snepytago/Four-Wheel-Mecanum-Robot/bao_cao_ekf.pdf

## Ước lượng tư thế robot mecanum bằng bộ lọc Kalman mở rộng (EKF)

kết hợp camera ArUco, encoder bánh xe và con quay hồi chuyển

Đồ án FWMR — STM32F401RE

Tháng 10/2026

Tóm tắt nội dung

Báo cáo trình bày cơ sở toán học và cách hiện thực bộ lọc Kalman mở rộng (EKF) dùng để ước lượng tư thế (X, Y, θ) của robot 4 bánh mecanum trên hệ tọa độ của camera trần. Bộ lọc trộn ba nguồn: (i) độ dời thân xe tính từ 4 encoder qua động học thuận, (ii) vận tốc góc từ con quay MPU6050, (iii) tư thế tuyệt đối của mã ArUco do camera đo, vốn có trễ và nhiễu. Vector trạng thái được mở rộng thêm bias còn dư của con quay để bộ lọc tự hiệu chỉnh trong lúc chạy. Mọi công thức trong mã nguồn (ekf.c) đều được chứng minh từng bước: mô hình chuyển động và sai số rời rạc hóa, ma trận Jacobian, lan truyền hiệp phương sai, độ lợi Kalman tối ưu, tính quan sát được của bias, cổng loại ngoại lai χ
2 và cơ chế bù
trễ camera. Cuối báo cáo là một ví dụ số tính tay đầy đủ cho một chu kỳ lọc và kết quả mô phỏng.

## Mục lục

1 Đặt vấn đề | 3
2 Mô hình hệ thống | 3
3 Thuật toán EKF và các chứng minh | 6

### 4 Cổng loại ngoại lai χ

2 | 10
5 Bù độ trễ camera | 11
6 Khởi tạo | 12
7 Ví dụ số: một chu kỳ dự đoán và hiệu chỉnh | 13
8 Hiện thực trên STM32F401RE | 15
9 Kết quả mô phỏng | 15
10 Hạn chế và hướng phát triển | 16
A Đối chiếu ký hiệu với mã nguồn | 17

## 1 Đặt vấn đề

Robot cần biết chính xác vị trí và hướng của mình để bám đường thẳng hoặc đi tới một điểm. Hệ thống có ba nguồn thông tin với đặc tính bổ sung cho nhau (Bảng 1).

Bảng 1: Đặc tính ba nguồn đo trên robot

Encoder (4 bánh) | Gyro Z (MPU6050) Camera ArUco
Đại lượng | Độ dời thân xe
| ∆xb, ∆yb | Vận tốc góc ω | Tư thế tuyệt đối
| | | (X, Y, θ)
Tần số | 50 Hz | 50 Hz | ≈ 30 Hz, không đều
Độ trễ | ≈ 0 | ≈ 0 | τ ≈ 200 ms (ước
| | | lượng)
Nhiễu | Trượt bánh 0–3% | σ ≈ 0,05◦ khi đứng yên σθ = 0,53◦
| | | (đã đo)
Sai số dài hạn | Tích lũy theo quãng
| đường | Bias làm góc trôi
| | tuyến tính | Không trôi
Mất tín hiệu | Không | Không | Có (che marker)

Encoder và gyro cho thông tin liên tục, không trễ nhưng là tương đối: chỉ biết xe đã đi thêm bao nhiêu, và sai số cộng dồn theo thời gian. Camera cho thông tin tuyệt đối nhưng chậm, trễ và có lúc mất. Bộ lọc Kalman mở rộng là công cụ chuẩn để kết hợp hai loại nguồn này theo nghĩa tối ưu bình phương trung bình: dùng encoder + gyro để dự đoán, dùng camera để hiệu chỉnh, và trọng số giữa hai bên được tính tự động từ độ bất định của từng bên.

## 2 Mô hình hệ thống

### 2.1 Hệ tọa độ và quy ước

- Hệ thế giới {G}: hệ của camera trần, trục XG, YG nằm trên mặt sàn. Camera gửi x, y theo cm và θ theo rad; firmware đổi sang m và rad.
- Hệ thân xe {B}: gốc tại tâm robot, trục xb hướng về mũi xe, trục yb sang trái.
- Góc θ: góc từ XG tới xb, dương ngược chiều kim đồng hồ khi nhìn từ trên xuống. Quy ước này đã được kiểm chứng trên phần cứng (24/09/2026): xoay robot 90◦ ngược chiều kim đồng hồ, camera đọc 96,8
| ◦ và gyro đọc 96,7

◦
| | , cùng dấu.

Ma trận quay từ {B} sang {G}:
R(θ) = "
| | cos θ − sin θ
sin θ | cos θ
. | (1)

### 2.2 Động học mecanum: từ động học nghịch tới động học thuận

Theo quy ước Taheri và cộng sự (2015) đang dùng trong firmware, vận tốc góc 4 bánh ω =

[ωF L, ωF R, ωRL, ωRR]

T liên hệ với vận tốc thân xe v = [vx, vy, ωz]

T qua động học nghịch:

ω =

1
r

Jv, J =

1 −1 −K
1 | 1 | K
1 | 1 | −K
1 −1 | K
, | (2)

với r = 0,034 m là bán kính bánh và K = g + h = 0,17125 m.
Ở chiều ngược lại, ta có 4 phương trình nhưng chỉ 3 ẩn, nên hệ là quá xác định. Động học thuận được định nghĩa là nghiệm bình phương tối thiểu.

Mệnh đề 2.1 (Động học thuận). Nghiệm của bài toán minv∥Jv − rω∥
2
là

vx =

r
4

(ωF L + ωF R + ωRL + ωRR),

vy =

r
4

(−ωF L + ωF R + ωRL − ωRR),

ωz =

r
4K

(−ωF L + ωF R − ωRL + ωRR).

(3)

Chứng minh. Bước 1 (phương trình chuẩn). Đặt E(v) = (Jv − rω)

T(Jv − rω). Đạo hàm theo
v và cho bằng 0:
∇vE = 2J

T
(Jv − rω) = 0 =⇒ J

TJ v = r JTω.

Bước 2 (tính J

TJ). Gọi c1, c2, c3 là ba cột của J:

c1 = (1, 1, 1, 1)T

, | c2 = (−1, 1, 1, −1)T
, | c3 = (−K, K, −K, K)

T

Các tích vô hướng:

c

T
1 c1 = 1 + 1 + 1 + 1 = 4, | c

T
1 c2 = −1 + 1 + 1 − 1 = 0, c

T
2 c2 = 1 + 1 + 1 + 1 = 4, | c

T
1 c3 = −K + K − K + K = 0, c

T
3 c3 = 4K²
, | c T
2 c3 = (−1)(−K) + K + (−K) + (−1)K = 0.

Vậy J

TJ = diag(4, 4, 4K²
), ma trận đường chéo và khả nghịch vì K ̸= 0. Bước 3 (nghiệm). v = r (J

TJ)
−1J

Tω = r diag
| 1/4, 1/4,

1
4K²
| | J

Tω. Hàng thứ nhất của J

T là c

| | | T
| | | 1 =
(1, 1, 1, 1) nên vx =

r
4

P
i ωi

. Tương tự hàng thứ hai cho vy. Hàng thứ ba là c

| | T
3 = K(−1, 1, −1, 1),
nhân với r
4K² được ωz =

r
4K

(−ωF L + ωF R − ωRL + ωRR).
Bước 4 (cực tiểu). Ma trận Hessian 2J

TJ xác định dương nên điểm dừng là cực tiểu toàn cục.

Từ xung encoder tới độ dời. Trong một chu kỳ ∆t = 20 ms, encoder bánh i đếm được ni xung (đã nhân dấu ENC_SIGN). Với N = 1496 xung/vòng, góc quay của bánh là ∆φi = 2πni/N. Vì (3) tuyến tính, thay vận tốc góc bằng góc quay sẽ được thẳng độ dời thân xe ∆xb, ∆yb trong chu kỳ đó, không cần chia cho ∆t rồi nhân lại. Firmware nhân thêm hệ số trượt:

∆xb ← Kslip,x ∆xb, | ∆yb ← Kslip,y ∆yb, | Kslip,x = 0,97, Kslip,y = 0,75. | (4)

Thành phần quay ωz của (3) không được dùng trong EKF: góc quay lấy từ gyro, vì bánh mecanum trượt khi quay làm ωz tính từ encoder kém tin cậy.

### 2.3 Động học liên tục của tư thế

Vận tốc thân xe (vx, vy) được quay sang hệ {G} bằng (1):

X˙ = vx cos θ − vy sin θ, | Y˙ = vx sin θ + vy cos θ, | ˙θ = ω. | (5)

### 2.4 Rời rạc hóa theo góc trung điểm và sai số của nó

Firmware tích phân (5) bằng góc trung điểm θm = θk +

| 1 2∆θ:
"
Xk+1

Yk+1 #

=

"
| Xk
| Yk

| + R(θm)

"
| ∆xb
| ∆yb
| . | | (6)

Mệnh đề 2.2 (Sai số của phép tích phân trung điểm). Giả sử trong một chu kỳ ∆t vận tốc thân xe vb và vận tốc góc ω không đổi, đặt ∆θ = ω∆t và ∆pb = vb∆t. Khi đó độ dời chính xác trên {G} là

∆p

đúng

G = sinc ∆θ

2

R(θm) ∆pb, sinc(u) = sin u
u
. | (7)

Nghĩa là công thức trung điểm (6) đúng về hướng, chỉ sai về độ dài một tỉ lệ 1 − sinc(∆θ/2) = ∆θ

2/24 + O(∆θ

4
).

Chứng minh. Bước 1. Với θ(t) = θk + ωt, độ dời chính xác là ∆pG =

R ∆t
0 | R(θk + ωt) vb dt = hR ∆t
0 | R(θk + ωt) dti
vb.

Bước 2 (tích phân từng phần tử). Với ω ̸= 0:

Z ∆t

0

cos(θk + ωt) dt =

sin(θk + ∆θ) − sin θk
ω

=

2
ω

# cos

θk +

∆θ
2
sin ∆θ
2

,

Z ∆t

0

sin(θk + ωt) dt =

cos θk − cos(θk + ∆θ)
ω

=

2
ω

## sin

θk +

∆θ
2
sin ∆θ
2

,

dùng công thức biến hiệu thành tích

sin a − sin b = 2 cos a+b
2

sin a−b
2

, cos b − cos a = 2 sin a+b
2

sin a−b
2

Bước 3. Ghép lại thành ma trận: R ∆t
0 R dt =

2 sin(∆θ/2)
ω R(θm) = ∆t

sin(∆θ/2)
∆θ/2 R(θm). Nhân với vb
và dùng vb∆t = ∆pb ta được điều phải chứng minh. Khi ω → 0, sinc → 1 nên công thức vẫn đúng theo giới hạn.
Bước 4 (khai triển). sinc(u) = 1−u

2/6 +O(u

4
), thay u = ∆θ/2 được 1− ∆θ

2/24 +O(∆θ

4
).

Bảng 2: Sai số tương đối độ dài mỗi chu kỳ 20 ms: trung điểm so với Euler (dùng θk đầu chu kỳ)

Tình huống | ∆θ (rad) Trung điểm | Euler (lệch hướng)
∆θ
| | 2/24 | ≈ ∆θ/2
Chạy thẳng (ω ≈ 0,02 rad/s) | 4 · 10−4 | 7 · 10−9 | 2 · 10−4
Đổi hướng (ω = 0,6 rad/s) | 0,012 | 6 · 10−6 | 6 · 10−3
Xoay tại chỗ (ω = 1,5 rad/s) | 0,03 | 3,8 · 10−5 | 1,5 · 10−2

Bảng 2 cho thấy sai số rời rạc hóa của công thức trung điểm nhỏ hơn sai số encoder (cỡ 10−2 )
hàng nghìn lần, nên có thể bỏ qua.

### 2.5 Mô hình con quay và bias

Giá trị gyro đọc được (đã trừ bias hiệu chuẩn lúc khởi động) được mô hình hóa

ωm = ω + b + ng, ng ∼ N (0, σ²
g
), | (8)

trong đó b là bias còn dư: phần hiệu chuẩn lúc khởi động chưa trừ hết, hoặc do nhiệt độ thay đổi. Bias thay đổi chậm, mô hình hóa bằng quá trình Wiener (bước ngẫu nhiên) ˙b = nb.

Bổ đề 2.3. Rời rạc hóa ˙b = nb với mật độ phổ q
2
b

trên chu kỳ ∆t cho bk+1 = bk + wb với Var(wb) = q

2
b ∆t.

Chứng minh. wb =

R tk+∆t

tk

nb(s) ds. Vì nb là nhiễu trắng, E[nb(s)nb(s

′
)] = q

2
b

δ(s − s

′
), do đó
Var(wb) = RR E[nb(s)nb(s
′

)] ds ds′ =

R tk+∆t

tk

q

2
b

ds = q

2
b∆t.

### 2.6 Mô hình trạng thái rời rạc

Vector trạng thái (4 biến):

x =

h

X Y θ biT
(m, m, rad, rad/s).

Đầu vào mỗi chu kỳ: uk = [∆xb, ∆yb, ωm]

T và ∆t đo thực tế.
Mô hình chuyển động xk+1 = f(xk, uk) + wk:

ω¯ = ωm − bk, θm = θk +
1/2 ω¯∆t,

Xk+1 = Xk + ∆xb cos θm − ∆yb sin θm,

Yk+1 = Yk + ∆xb sin θm + ∆yb cos θm,

θk+1 = wrap(θk + ¯ω∆t),

bk+1 = bk.

(9)

Mô hình đo (khi có khung camera):

z =

Xc
Yc
θc
- = Hx + v, H =

1 0 0 0
0 1 0 0
0 0 1 0
- = [ I3 0 ], | v ∼ N (0, R). | (10)

Hàm wrap(·) đưa góc về (−π, π]. Mô hình đo là tuyến tính; phần phi tuyến chỉ nằm ở mô hình chuyển động (các hàm sin, cos của θ), vì vậy cần bộ lọc Kalman mở rộng.

## 3 Thuật toán EKF và các chứng minh

Bộ lọc giữ ước lượng xˆ và ma trận hiệp phương sai P = E[(x − xˆ)(x − xˆ)

T]. Mỗi chu kỳ gồm
bước dự đoán (luôn chạy, 50 Hz) và bước hiệu chỉnh (chỉ khi có khung camera).

### 3.1 Tuyến tính hóa: ma trận Jacobian F

Mệnh đề 3.1 (Jacobian của mô hình chuyển động). Đặt a = −∆xb sin θm − ∆yb cos θm và β = ∆xb cos θm − ∆yb sin θm. Khi đó

F =

∂f
∂x
xˆk

=

1 0 a −

∆t
2

a
0 1 β −

∆t
2

β
0 0 1 | −∆t
0 0 0 | 1
. | (11)

Chứng minh. Lấy đạo hàm riêng từng hàng của (9) theo từng biến trạng thái.

Bước 1 (biến trung gian). θm = θ +

1/2(ωm − b)∆t nên ∂θm
∂θ = 1,

∂θm
∂b = −

∆t
2

, và θm không phụ
thuộc X, Y .
Bước 2 (hàng X). ∂Xk+1
∂X = 1,

∂Xk+1
∂Y = 0. Theo quy tắc dây chuyền:

∂Xk+1
∂θ =

∂Xk+1
∂θm

·

∂θm
∂θ = (−∆xb sin θm − ∆yb cos θm) · 1 = a,

∂Xk+1
∂b = a ·
−

∆t
2

Bước 3 (hàng Y ). Tương tự, ∂Yk+1 ∂θm

= ∆xb cos θm − ∆yb sin θm = β, nên ∂Yk+1

∂θ | = β và ∂Yk+1
∂b | =

−

∆t
2

β.

Bước 4 (hàng θ). θk+1 = θ + (ωm − b)∆t cho ∂θk+1 ∂θ = 1,

∂θk+1
∂b = −∆t. (Hàm wrap chỉ cộng bội số 2π, đạo hàm bằng 1.)

Bước 5 (hàng b). bk+1 = b cho hàng (0, 0, 0, 1).

Nhận xét. Gọi (∆X, ∆Y ) = R(θm)(∆xb, ∆yb) là độ dời trên {G} trong chu kỳ. So với (9) thấy ngay a = −∆Y và β = ∆X. Ý nghĩa: sai lệch góc δθ làm điểm cuối lệch đi δθ ·(−∆Y, ∆X), tức vector độ dời bị quay 90◦ và nhân δθ. Đó chính là “cánh tay đòn” biến sai số góc thành sai số vị trí.

### 3.2 Lan truyền hiệp phương sai

Mệnh đề 3.2. Với sai số ước lượng ek = xk − xˆk có trung bình 0, hiệp phương sai Pk, và nhiễu quá trình wk trung bình 0, hiệp phương sai Qk, độc lập với ek, thì đến bậc nhất:

P

−
k+1 = F PkF
T + Qk. | (12)

Chứng minh. Bước 1 (khai triển Taylor). f(xk, u) = f(xˆk, u) + F(xk − xˆk) + O(∥ek∥

2
).
Bước 2 (sai số sau dự đoán). Dự đoán xˆ

−
k+1 = f(xˆk, u), nên e

−
k+1 = xk+1 − xˆ

−
k+1 ≈ Fek + wk.
Bước 3 (trung bình). E[e

−
k+1] = FE[ek] + E[wk] = 0.

Bước 4 (hiệp phương sai).

E[e

−
k+1e

−T
k+1] = FE[eke

T
k

]F

T + FE[ekwT
k

] + E[wke

T
k

]F

T + E[wkwT
k

].

Hai số hạng giữa bằng 0 vì ek và wk độc lập, trung bình 0. Còn lại F PkF

T + Qk.

### 3.3 Xây dựng ma trận nhiễu quá trình Q

Q có cấu trúc khối Q = diag(Qxy, qθ, qb), mỗi khối mô tả một nguồn sai số vật lý.

a) Khối vị trí. Sai số độ dời encoder tỉ lệ với quãng đường (trượt bánh) cộng một mức sàn:
σx = kx d + σ0, | σy = ky d + σ0, | d =

q
∆x

2
b + ∆y

2
b
, | (13)

với kx = 0,03 (trượt 0–3% đã đo), ky = 0,10 (hướng ngang kém tin cậy hơn), σ0 = 0,5 mm. Các sai số này nằm trong hệ {B} và cần quay sang {G}.

Mệnh đề 3.3. Nếu δpb ∼ N (0, Σb) với Σb = diag(qx, qy), qx = σ
2
x

, qy = σ

2
y

, thì δpG = R(θm)δpb
có hiệp phương sai

Qxy =

"
c

2
qx + s

2
qy cs(qx − qy)
cs(qx − qy) s

2
qx + c

2
qy
, | c = cos θm, s = sin θm. | (14)

Chứng minh. Cov(R δpb) = R ΣbRT. Tính từng bước:

RΣb =

"
c −s
s | c # "qx | 0
| 0 | qy

=

"
cqx | −sqy
sqx | cqy

,

RΣbR

T =

"
cqx | −sqy
sqx | cqy
# " c | s

−s c#

=

"
c

2
qx + s

2
qy | cs qx − cs qy
cs qx − cs qy | s

2
qx + c

2
qy

Khi qx = qy khối này trở thành qxI, không phụ thuộc hướng; khi qy > qx (hướng ngang kém tin), số hạng chéo khác 0 và elip bất định nằm dọc theo trục ngang của thân xe, đúng như mong đợi.

b) Khối góc. σθ = σg∆t + ks|ω¯∆t|, gồm nhiễu gyro σg = 0,5

◦/s và sai số tỉ lệ khi xoay
ks = 2%. Vậy qθ = σ

2
θ

c) Khối bias. Theo Bổ đề 2.3: qb = (0,02◦/s)
2
- ∆t (đơn vị ◦/s/√
s đổi sang rad).

### 3.4 Bước hiệu chỉnh: độ lợi Kalman tối ưu

Khi có phép đo z, ước lượng được hiệu chỉnh tuyến tính theo sai lệch đo (innovation) r = z−Hxˆ

−:

xˆ

+ = xˆ

− + Kr. | (15)

Định lý 3.4 (Độ lợi Kalman). Đặt S = HP −HT + R. Ma trận K làm cực tiểu tổng phương sai sai số tr P

+ = E∥x − xˆ
+∥

2
là
K = P

### −HTS

−1
, | (16)

và với K này, P

+ = (I − KH)P

−.

Chứng minh. Bước 1 (sai số sau hiệu chỉnh). Với z = Hx + v:

e

+ = x − xˆ

− − K(Hx + v − Hxˆ

−) = (I − KH)e

− − Kv.

Bước 2 (hiệp phương sai, dạng Joseph). Vì e

− và v độc lập, trung bình 0:

P

+ = (I − KH)P

−(I − KH)

T + KRKT
. | (17)

Bước 3 (khai triển).

P

+ = P

− − KHP − − P

−HTKT + KHP −HTKT + KRKT

= P

− − KHP − − P

−HTKT + KSKT

Bước 4 (lấy vết và đạo hàm theo K). Dùng các đẳng thức đạo hàm ma trận ∂ tr(KA) ∂K = AT,
∂ tr(AKT)
∂K = A,

∂ tr(KBKT)
∂K = K(B + BT):

∂ tr P

+
∂K = −(HP −)

T − P

−HT + 2KS = −2P

−HT + 2KS,

vì P

− và S đối xứng. Cho bằng 0 được K = P

### −HTS

−1
Bước 5 (cực tiểu). tr P

+ là hàm bậc hai theo K với phần bậc hai tr(KSKT). S xác định dương (xem Bước 6) nên hàm lồi chặt, điểm dừng là cực tiểu toàn cục.

Bước 6 (S khả nghịch). P

− nửa xác định dương, R xác định dương, nên với mọi y ̸= 0: y

TSy = (HTy)

TP

−(HTy) + y

TRy > 0.

Bước 7 (rút gọn P

+). Từ K = P

### −HTS

−1
suy ra KS = P

−HT, nên KSKT = P

−HTKT.
Thay vào Bước 3, hai số hạng −P

−HTKT và +KSKT triệt tiêu: P
+ = P

− − KHP − =

(I − KH)P

−.

Nhận xét (Trực giác 1 chiều). Với một biến vô hướng, H = 1: K =

p
p + r

và p

+ =

p r
p + r

. Nếu dự

đoán chắc chắn hơn camera (p ≪ r) thì K → 0, bỏ qua camera. Nếu camera chắc hơn (r ≪ p) thì K → 1, tin camera. Khi p = r: K =
1/2 và p

+ =

r
2

, tức độ lệch chuẩn giảm √ 2 lần. Ví dụ số
ở Mục 7 cho đúng kết quả này.

### 3.5 Rút gọn với H = [ I3 0 ]

Với H ở (10), các tích ma trận trở nên rất đơn giản:

HP −HT = P
−
1:3, 1:3, | P −HT = P
−
1:4, 1:3, | (18)

tức chỉ cần cắt ma trận, không cần nhân. Do đó

S = P

−
1:3,1:3 + R, | K = P

−
1:4,1:3 S

−1
(4 × 3), P ⁺
ij = P

−
ij −

X

3

m=1

KimP

−
mj . | (19)

Đây đúng là ba vòng lặp trong ekf_update_cam.

Nghịch đảo 3 × 3. Firmware tính S

−1 = adj(S)/ det S bằng phần bù đại số. Với Cij = (−1)i+jMij (Mij là định thức con bỏ hàng i, cột j): det S =

P
j S1jC1j (khai triển theo hàng
1) và (S

−1
)ij = Cji/ det S. Chứng minh: (S adj S)ik =

P
j SijCkj ; khi i = k đây là khai triển det S theo hàng i; khi i ̸= k đây là định thức của ma trận có hai hàng bằng nhau, bằng 0. Vậy S adj S = (det S)I.

Sai lệch góc. Camera trả θc ∈ (−π, π] nên sai lệch góc phải chuẩn hóa: rθ = wrap(θc − ˆθ −).
Ví dụ θc = 179◦
,

ˆθ
− = −179◦

: hiệu thô là 358◦
, nhưng hai hướng chỉ cách nhau −2

◦
; không
chuẩn hóa thì bộ lọc sẽ quay ước lượng gần một vòng.

### 3.6 Bias gyro quan sát được: vì sao EKF học được b

Không cảm biến nào đo trực tiếp b (hàng 4 của H bằng 0), nhưng bộ lọc vẫn ước lượng được nó.

Mệnh đề 3.5 (Tính quan sát được). Cặp (F, H) của (11), (10) quan sát được với mọi ∆t > 0.

Chứng minh. Ma trận quan sát được là O =

H
HF
. Ba hàng của H là e

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
. Hàng thứ ba

của HF là hàng thứ ba của F: (0, 0, 1, −∆t). Trừ đi e

T
3 được (0, 0, 0, −∆t), độc lập tuyến tính với e1, e2, e3 khi ∆t ̸= 0. Vậy rank O = 4.

Cơ chế cụ thể thấy rõ trên mô hình rút gọn hai biến (θ, b) khi xe đứng yên.

Ví dụ 3.6 (Một chu kỳ trên mô hình (θ, b)). Giả sử P = diag(pθ, pb), F2 =

"
1 −∆t

0 1 #
, bỏ qua

Q.
Dự đoán:

F2P F T
2 =

"
pθ | −∆t pb
0 | pb
# " 1 | 0

−∆t 1

=

"
pθ + ∆t
2pb | −∆t pb
−∆t pb | pb

Phần tử chéo −∆t pb là tương quan âm giữa sai số góc và sai số bias: bias ước lượng thấp hơn thật thì góc dự đoán sẽ cao hơn thật.
Hiệu chỉnh với camera góc (H2 = [1 0], phương sai đo rc): S = pθ + ∆t

2pb + rc và

K =

1
S

"
pθ + ∆t

2pb
−∆t pb

, δb = K2 rθ = −

∆t pb
S

rθ.

Diễn giải: nếu camera thấy góc nhỏ hơn dự đoán (rθ < 0), tức gyro đã báo quay nhiều hơn thực tế, thì δb > 0: bias được tăng lên và từ chu kỳ sau ω¯ = ωm − b nhỏ đi. Sau nhiều chu kỳ, các hiệu chỉnh nhỏ này cộng dồn và ˆb hội tụ về bias thật (Hình 1).

Đây là lợi ích lớn nhất của EKF trong hệ này: khi còn thấy camera, toàn bộ quãng chạy trở thành một phiên hiệu chuẩn gyro liên tục, nên khi mất camera (che marker), góc vẫn bền hơn nhiều so với chỉ hiệu chuẩn một lần lúc khởi động.

## 4 Cổng loại ngoại lai χ

2

Camera có thể trả khung sai (nhận nhầm marker, nhiễu ảnh). Firmware loại khung có khoảng cách Mahalanobis lớn:
d

2 = r

TS
−1
r > γ = 16,3. | (20)

Mệnh đề 4.1. Nếu mô hình đúng thì r ∼ N (0, S) và d
2 ∼ χ
2/3(phân phối chi bình phương 3 bậc tự do).

Chứng minh. Bước 1. r = He

− + v là tổ hợp tuyến tính của các biến Gauss trung bình 0, nên Gauss với hiệp phương sai HP −HT + R = S.
Bước 2 (làm trắng). S xác định dương nên có phân tích Cholesky S = LLT. Đặt y = L
−1
r:
Cov(y) = L

−1SL−T = L

−1LLTL

−T = I3, nên y1, y2, y3 độc lập, cùng phân phối N (0, 1).

Bước 3. d

2 = r

T(LLT)
−1
r = (L

−1
r)

T(L
−1
r) = y

2
1 + y

2
2 + y

2/3, chính là định nghĩa của χ

2/3.

Bảng 3: Ngưỡng cổng và xác suất loại nhầm một khung đúng

Mức tin cậy | Ngưỡng γ = F

−1
χ

2
3
| | Xác suất loại nhầm
95% | 7,81 | 5%
99% | 11,34 | 1%
99,9% (đang dùng) | 16,27 | 0,1%

Nạp lại khi bị loại liên tiếp. Nếu 10 khung liên tiếp bị loại, có nhiều khả năng chính EKF đã sai (ví dụ đặt sai độ trễ, hoặc xe bị nhấc lên), nên firmware đặt lại X, Y, θ theo khung camera và giữ nguyên bias. Với khung đúng, xác suất 10 lần loại nhầm liên tiếp là (10−3
)

10 = 10−30
,
không đáng kể.

## 5 Bù độ trễ camera

Khung camera nhận ở thời điểm t mô tả vị trí robot ở thời điểm chụp t − τ . Firmware lưu lịch sử trạng thái của 64 chu kỳ gần nhất (1,28 s) và so khung camera với trạng thái lúc chụp.

### 5.1 Sai số khi không bù trễ

Mệnh đề 5.1. Xe chạy thẳng với vận tốc v dọc trục X. Nếu so khung camera với trạng thái hiện tại, ước lượng ở trạng thái ổn định bị kéo lùi một lượng xấp xỉ vτ (khi bộ lọc tin camera nhiều).

Chứng minh. Bỏ qua nhiễu: Xc(t) = X(t − τ ) = X(t) − vτ . Sai lệch đo r = Xc − Xˆ(t) = (X(t) − Xˆ(t)) − vτ . Ở trạng thái ổn định, bước hiệu chỉnh kéo r về quanh 0 (giữa hai lần cập nhật encoder chỉ cộng đúng độ dời thật), nên X(t) − Xˆ(t) → vτ , tức ước lượng nằm sau vị trí thật đúng vτ .

Với v = 0,5 m/s và τ = 0,2 s, sai số là 10 cm. Hình 2 (mô phỏng) cho kết quả ≈ 95 mm, đúng như dự đoán.

### 5.2 Phương pháp bù và sai số còn lại

Gọi xˆ(t − τ ) là trạng thái lưu trong lịch sử. Sai lệch đo dùng trong firmware là

r = z − Hxˆ(t − τ ), | (21)

còn hiệu chỉnh δ = Kr được cộng vào trạng thái hiện tại.

Mệnh đề 5.2. Viết xˆ(t) = xˆ(t − τ ) ⊕ ∆ˆ , trong đó ∆ˆ là độ dời odometry trong khoảng [t − τ, t]. Hiệu chỉnh (δX, δY, δθ) tính tại t−τ khi cộng thẳng vào trạng thái hiện tại có sai số vị trí không vượt quá |δθ| · ∥∆p∥ ≤ |δθ| vτ .

Chứng minh. Bước 1. Nếu tại t − τ tư thế được sửa thành (X + δX, Y + δY, θ + δθ) thì, chạy lại odometry từ đó, độ dời trong [t − τ, t] được quay thêm δθ: ∆p

′ = R(δθ)∆p.

Bước 2. Vị trí hiện tại đúng phải là p(t − τ ) + (δX, δY ) + R(δθ)∆p. Firmware dùng p(t − τ ) + (δX, δY ) + ∆p. Hiệu hai biểu thức là (R(δθ) − I)∆p.

Bước 3. ∥(R(δθ) − I)u∥ = 2|sin(δθ/2)| ∥u∥ ≤ |δθ| ∥u∥ (độ dài dây cung). Với ∥∆p∥ ≤ vτ ta có điều phải chứng minh. Góc được hiệu chỉnh chính xác vì phép cộng góc giao hoán.

Ví dụ: δθ = 1◦ = 0,0175 rad, v = 0,5 m/s, τ = 0,2 s cho sai số tối đa 1,75 mm, nhỏ hơn 50 lần so với không bù.

### 5.3 Phải dịch cả lịch sử

Mệnh đề 5.3. Sau khi cộng δ vào trạng thái hiện tại, nếu không cộng δ vào mọi phần tử lịch sử thì hiệu chỉnh này bị áp dụng lặp lại ở khung sau.

Chứng minh. Khung kế tiếp có thời điểm chụp t

′−τ , thường vẫn nằm trước thời điểm hiệu chỉnh t, nên được so với phần tử lịch sử xˆh chưa sửa. Khi đó r

′ = z

′ − Hxˆh =

z

′ − H(xˆh + δ)

+ Hδ.
Số hạng Hδ là phần sai lệch đã được sửa nhưng lại xuất hiện trong r

′
, nên bị cộng thêm lần
nữa, gây vọt lố. Cộng δ vào toàn bộ lịch sử làm số hạng này biến mất.

Xấp xỉ còn lại. Firmware dùng P hiện tại thay cho P(t − τ ) khi tính S và K. Trong 0,2 s, P chỉ tăng thêm ≈ 10 lần Q của một chu kỳ, nhỏ so với R, nên ảnh hưởng không đáng kể. Phương pháp chính xác hơn (nhân bản trạng thái, chạy lại toàn bộ lịch sử) tốn bộ nhớ và thời gian tính hơn nhiều mà không cần thiết ở đây.

## 6 Khởi tạo

Trung bình N khung. Khi xe đứng yên, firmware lấy trung bình N = 10 khung camera. Với các khung độc lập, phương sai của trung bình là σ

2/N, nên độ lệch chuẩn vị trí ban đầu giảm
√
10 ≈ 3,2 lần.

Trung bình góc theo đường tròn. Không được lấy trung bình cộng các góc: 179◦ và −179◦ cho trung bình cộng 0

◦

, trong khi hướng đúng là 180◦ . Firmware dùng
¯θ = atan2X

i

sin θi
,

X

i

cos θi

. | (22)

Mệnh đề 6.1. ¯θ cực tiểu hàm L(µ) = P

i

1 − cos(θi − µ)
, tức tổng bình phương khoảng cách dây cung giữa các điểm e

iθk và e
iµ trên đường tròn đơn vị (chia 2).

Chứng minh. Trước hết |e

iθk − e
iµ|

2 = 2 − 2 cos(θk − µ). Đạo hàm:

L

′
(µ) = −

X

i

sin(θi − µ) = − cos µ

X

i

sin θi + sin µ

X

i

cos θi

Cho bằng 0 được tan µ =

Psin θi/

Pcos θi
. Trong hai nghiệm cách nhau π, L

′′(µ) = Pcos(θi −

µ) = C cos µ + S sin µ (với C =

Pcos θi
, S =

Psin θi) dương khi (cos µ,sin µ) cùng hướng với

(C, S), đúng nghiệm mà atan2(S, C) trả về.

Hiệp phương sai ban đầu. P0 = diag
σ

2

xy, σ²

xy, σ²

θ,c, σ²
b,0
với σxy = 1 cm, σθ,c = 0,53◦ ,

σb,0 = 0,5

◦/s; ˆb0 = 0. Trong 3 s đếm ngược (xe đứng yên, camera vẫn chạy), bộ lọc học bias trước khi xe chuyển động (Hình 1).

## 7 Ví dụ số: một chu kỳ dự đoán và hiệu chỉnh

Các số dưới đây được tính bằng đúng thuật toán của ekf.c, làm tròn để trình bày. Đơn vị: m, rad, rad/s.

Dữ liệu. Trạng thái đầu xˆ = (1,000; 0,500; 0,17453; 0), tức θ = 10◦ , ngay sau khởi tạo nên
P = P0 = diag(10−4

, 10−4

, 8,557 · 10−5

, 7,615 · 10−5
). Đầu vào một chu kỳ: ∆xb = 0,0098 m
(0,49 m/s), ∆yb = 0,0002 m, ωm = 0,0100 rad/s, ∆t = 0,02 s.

Bước 1 — Dự đoán trạng thái

ω¯ = 0,0100 − 0 = 0,0100, θm = 0,17453 + 1
2

(0,0100)(0,02) = 0,17463,

c = cos θm = 0,98479, s = sin θm = 0,17375,
X− = 1,000 + 0,0098(0,98479) − 0,0002(0,17375) = 1,009616,

Y

− = 0,500 + 0,0098(0,17375) + 0,0002(0,98479) = 0,501900,

θ

− = 0,17453 + 0,0100(0,02) = 0,174733, b− = 0.

Bước 2 — Jacobian

a = −0,0098(0,17375) − 0,0002(0,98479) = −1,8997 · 10−3 ,
β = 0,0098(0,98479) − 0,0002(0,17375) = 9,6162 · 10−3
,

F =

1 0 −1,8997 · 10−3 | 1,8997 · 10−5
0 1 | 9,6162 · 10−3 | −9,6162 · 10−5
0 0 | 1 | −0,02
0 0 | 0 | 1

Bước 3 — Nhiễu quá trình

d =

p
0,0098² + 0,0002² = 9,802 · 10−3 m; σx = 0,03d + 0,0005 = 7,941 · 10−4 , σy = 0,10d +
0,0005 = 1,480 · 10−3

; qx = 6,305 · 10−7

, qy = 2,191 · 10−6
. Theo Mệnh đề 3.3:

Q11 = c

2
qx + s

2

qy = 6,776 · 10−7
, Q22 = s

2
qx + c

2

qy = 2,144 · 10−6
,
Q12 = cs(qx − qy) = −2,670 · 10−7 ,

σθ = (0,5

◦

/s)(0,02) + 0,02 · |0,0100 · 0,02| = 1,785 · 10−4

rad ⇒ Q33 = 3,187 · 10−8
,
Q44 = (0,02◦
/s đổi ra rad/s)

2

- 0,02 = 2,437 · 10−9

Bước 4 — Hiệp phương sai dự đoán P

− = F P F T + Q

P

− =

1,0068 · 10−4 | −2,686 · 10−7 | −1,626 · 10−7 | 1,45 · 10−9
−2,686 · 10−7 | 1,0215 · 10−4 | 8,230 · 10−7 | −7,32 · 10−9
−1,626 · 10−7 | 8,230 · 10−7 | 8,5629 · 10−5 | −1,523 · 10−6
1,45 · 10−9 | −7,32 · 10−9 | −1,523 · 10−6 | 7,6157 · 10−5

Kiểm tra một phần tử: P

−
34 = F33P33F43 + F34P44F44 = 0 + (−0,02)(7,615 · 10−5 )(1) = −1,523 ·
10−6
. Đây chính là tương quan âm giữa θ và b đã phân tích ở Ví dụ trên.

Bước 5 — Khung camera và sai lệch đo

Camera báo z = (1,0090; 0,5035; 0,1700):

r = z − Hxˆ

− = (−6,16 · 10−4

; 1,600 · 10−3

; −4,733 · 10−3
),

tức −0,6 mm, +1,6 mm và −0,27◦ .

Bước 6 — S, cổng χ
2
, độ lợi K

R = diag(10−4

, 10−4

, 8,557 · 10−5
),

S = P

−
1:3,1:3 + R =
2,0068 · 10−4 | −2,69 · 10−7 | −1,63 · 10−7
−2,69 · 10−7 | 2,0215 · 10−4 | 8,23 · 10−7
−1,63 · 10−7 | 8,23 · 10−7 | 1,7120 · 10−4
- ,

d

2 = r

TS
−1
r = 0,146 < 16,3 ⇒ nhận khung.

K = P

−
1:4,1:3S

−1 =

0,5017 | −6,6 · 10−4 | −4,7 · 10−4
−6,6 · 10−4 | 0,5053 | 2,38 · 10−3
−4,0 · 10−4 | 2,03 · 10−3 | 0,5002
1,3 · 10−9 | −6,7 · 10−9 | −8,897 · 10−3

Các phần tử đường chéo ≈ 0,5 vì ngay sau khởi tạo P

− ≈ R: theo nhận xét 1 chiều, K = p/(p + r) = 1/2. Hàng 4 (bias) chỉ khác 0 đáng kể ở cột góc, nhờ P

−
34 ̸= 0.

Bước 7 — Cập nhật

δ = Kr = (−3,08 · 10−4

; 7,98 · 10−4

; −2,364 · 10−3

; 4,21 · 10−5
),

xˆ

+ = (1,009308; 0,502698; 0,172369; 4,21 · 10−5

) ⇐⇒ θ = 9,876◦

, b = 0,0024◦
/s.

Độ lệch chuẩn sau cập nhật: σX = 7,08 mm, σY = 7,11 mm, σθ = 0,375◦

, σb = 0,49996◦/s. So
với trước (10 mm, 10 mm, 0,53◦

) đều giảm khoảng √
2 lần, đúng như Nhận xét 1 chiều. Bias thay đổi rất ít ở khung đầu tiên vì tương quan P

−
34 mới tích lũy được một chu kỳ; nó lớn dần qua các chu kỳ sau.

Bước 8 — Dịch lịch sử

Cộng (δX, δY, δθ) = (−0,31; 0,80 mm; −0,135◦ ) vào cả 64 phần tử lịch sử.

## 8 Hiện thực trên STM32F401RE

Khối lượng tính toán. Mỗi chu kỳ dự đoán: F P F T gồm 2×64 = 128 phép nhân–cộng, cộng Q và đối xứng hóa. Mỗi lần hiệu chỉnh: nghịch đảo 3 × 3 (≈ 30 phép tính), K (36), cập nhật P (48), dịch lịch sử (192 phép cộng). Tổng dưới 1000 phép tính dấu phẩy động mỗi chu kỳ, tức khoảng vài chục micro giây trên nhân Cortex-M4F có FPU, rất nhỏ so với chu kỳ 20 ms.

Ổn định số. Sau mỗi bước, P được đối xứng hóa P ← 1
2

(P + P

T) để chặn sai số làm tròn làm P mất đối xứng. Dạng P

+ = (I − KH)P

− được dùng thay dạng Joseph (17) để tiết kiệm phép tính; với float 32 bit và các phần tử P cỡ 10−9–10−4

(rất xa giới hạn 10−38), mô phỏng chưa cho thấy dấu hiệu mất xác định dương.

Khung camera “đóng băng”. Khi mất marker, phía PC gửi lại đúng pose cũ. Lúc xe đang chạy, hai khung giống hệt nhau là không thể xảy ra, nên firmware bỏ qua chúng.

Bảng 4: Tham số EKF trong config.h

Ký hiệu | Tên trong code | Giá trị | Nguồn
σxy (trong R) EKF_R_XY_M | 0,01 m | Ước lượng, chưa đo
σθ,c (trong R) EKF_R_TH_DEG | 0,53◦ | Đo 24/09/2026
kx | EKF_Q_ENC_X | 0,03 | Trượt 0–3% đã đo
ky | EKF_Q_ENC_Y | 0,10 | Ước lượng
σ0 | EKF_Q_ENC_MIN_M | 0,5 mm | Ước lượng
σg | EKF_Q_GYRO_DPS | 0,5
◦/s | Ước lượng (đo: 0,05° góc khi đứng yên)
ks | EKF_Q_GYRO_SCALE 0,02 | Ước lượng
qb | EKF_Q_BIAS_DPS | 0,02◦/s/√
s Ước lượng
σb,0 | EKF_B0_DPS | 0,5
◦/s | Ước lượng
γ | EKF_GATE | 16,3 | χ

2/3, 99,9%
τ | EKF_CAM_DELAY_MS 200 ms | Ước lượng, cần đo lại

## 9 Kết quả mô phỏng

Lưu ý: các kết quả trong mục này là mô phỏng trên máy tính (mô hình robot có nhiễu camera, bánh RR yếu 8%, bias gyro 0,4

◦/s, encoder đọc dư 3%), dùng để kiểm chứng tính đúng của thuật toán. Kết quả trên xe thật sẽ được bổ sung từ log.

Bảng 5: Bài go-to-point mô phỏng, 7 vị trí xuất phát ngẫu nhiên. τthật là độ trễ camera trong mô phỏng; firmware đặt τ = 200 ms.

τthật (ms) | Số lần | Sai số vị trí cuối | Sai số hướng
200 (đúng) | 4 | 2–5 mm | < 0,6

◦
100 hoặc 350 | 2 | 14–20 mm | < 0,3

◦
500 | 1 | 4 mm (sau khi tự chỉnh theo camera lúc
đứng yên)

0,1

◦

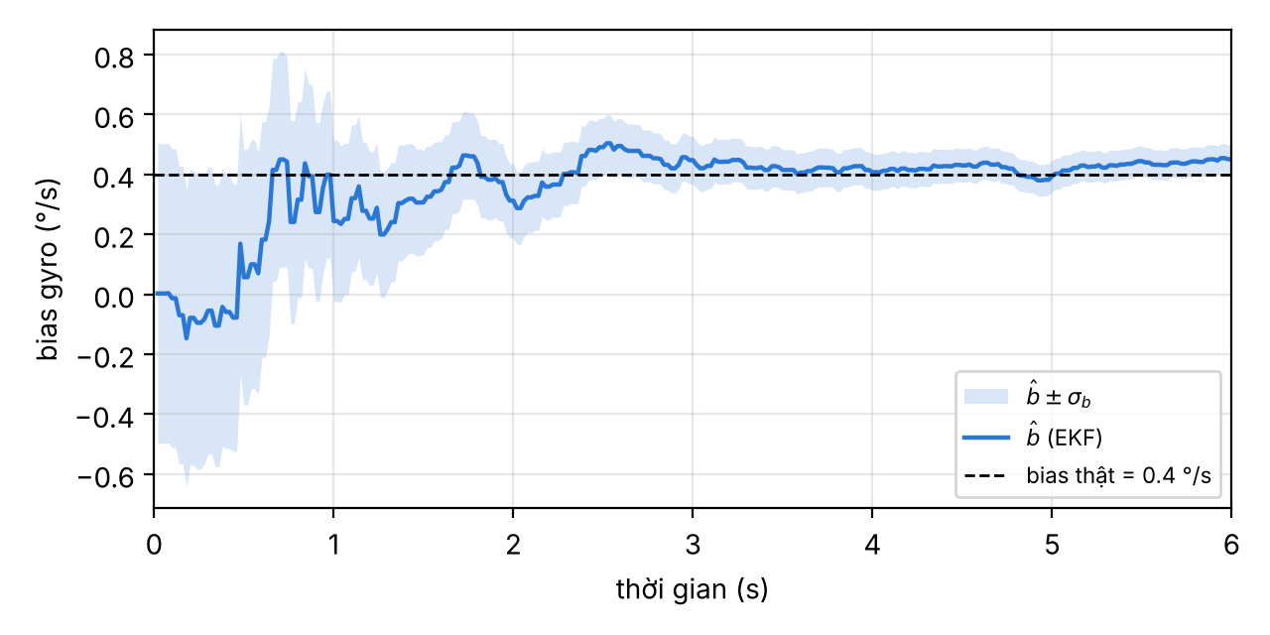
[picture p4: figure]

Hình 1: Hội tụ của bias gyro khi xe đứng yên, camera 30 Hz. Bias thật 0,4

◦/s; sau 3 s đếm ngược
ˆb = 0,45 ± 0,08◦/s, sau 6 s độ bất định còn ±0,05◦/s.

Với bài chạy thẳng 3 m có vòng giữ hướng và vòng kéo ngang dựa trên EKF, mô phỏng cho độ lệch ngang lớn nhất 6 mm và góc lệch lớn nhất 0,7

◦

## 10 Hạn chế và hướng phát triển

1. Độ trễ τ chưa đo. Theo Mệnh đề 5.1, sai ∆τ gây sai số cỡ v ∆τ khi đang chạy. Có thể đo bằng cách cho xe dừng đột ngột và so thời điểm encoder hết xung với thời điểm camera thấy xe dừng, hoặc thêm số thứ tự khung/timestamp vào gói tin camera.
2. Rxy chưa đo. Cần ghi pose camera khi xe đứng yên trong vài chục giây để tính độ lệch chuẩn thật của x, y.
3. Độ trễ giả định không đổi. Nếu độ trễ dao động mạnh, nên ước lượng nó theo từng khung.
4. Hệ số trượt Kslip,x, Kslip,y có thể đưa vào vector trạng thái để EKF tự ước lượng, giống cách đã làm với bias.
5. Đoạn mất camera (“hầm”). Bộ lọc đã tự chạy bằng dự đoán khi không có khung; cần thí nghiệm che marker để đo sai số lúc ra khỏi hầm.

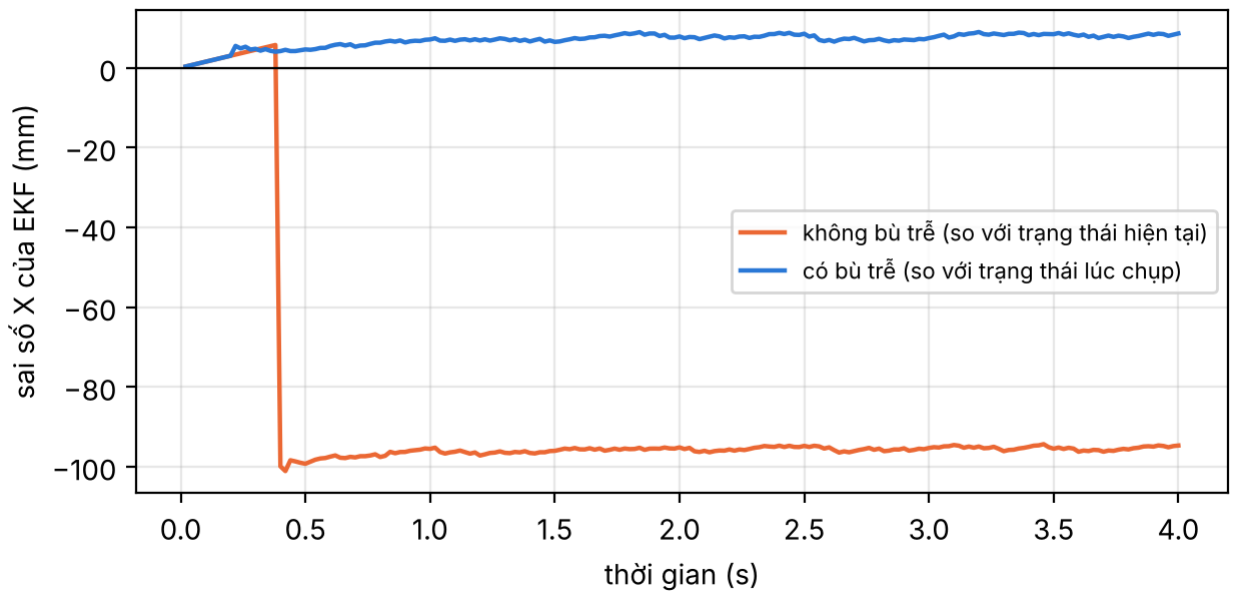
[picture p5: figure]

Hình 2: Sai số X của EKF khi xe chạy thẳng 0,5 m/s, camera trễ 200 ms. Không bù trễ: sau khi bị loại 10 khung liên tiếp, bộ lọc nạp lại theo camera và ổn định ở ≈ −95 mm, khớp với −vτ = −100 mm của Mệnh đề 5.1. Có bù trễ: sai số ≈ 8 mm, phần lớn do encoder đọc dư 3% mà bộ lọc phải liên tục kéo về.

## A Đối chiếu ký hiệu với mã nguồn

Ký hiệu | Biến/hàm trong ekf.c Ghi chú
xˆ = (X, Y, θ, b) s[0..3] | ekf_x/y/th/bias()
P | P[4][4]
∆xb, ∆yb | dx, dy | FK × K_SLIP
ωm | gz | rad/s
θm | tm
a, β | a, b | (11)
qx, qy | qx, qy | Mệnh đề 3.3
r | r[3] | so với lịch sử
S, S−1 | S, Si | phần bù đại số

d

2 | d2 | cổng χ
| | 2
K | K[4][3] | (16)
δ | d[4] | cộng vào trạng thái và lịch sử
Lịch sử | hx, hy, hth, ht | 64 phần tử
