snepytago/Four-Wheel-Mecanum-Robot/Claude outputs/fig1.png

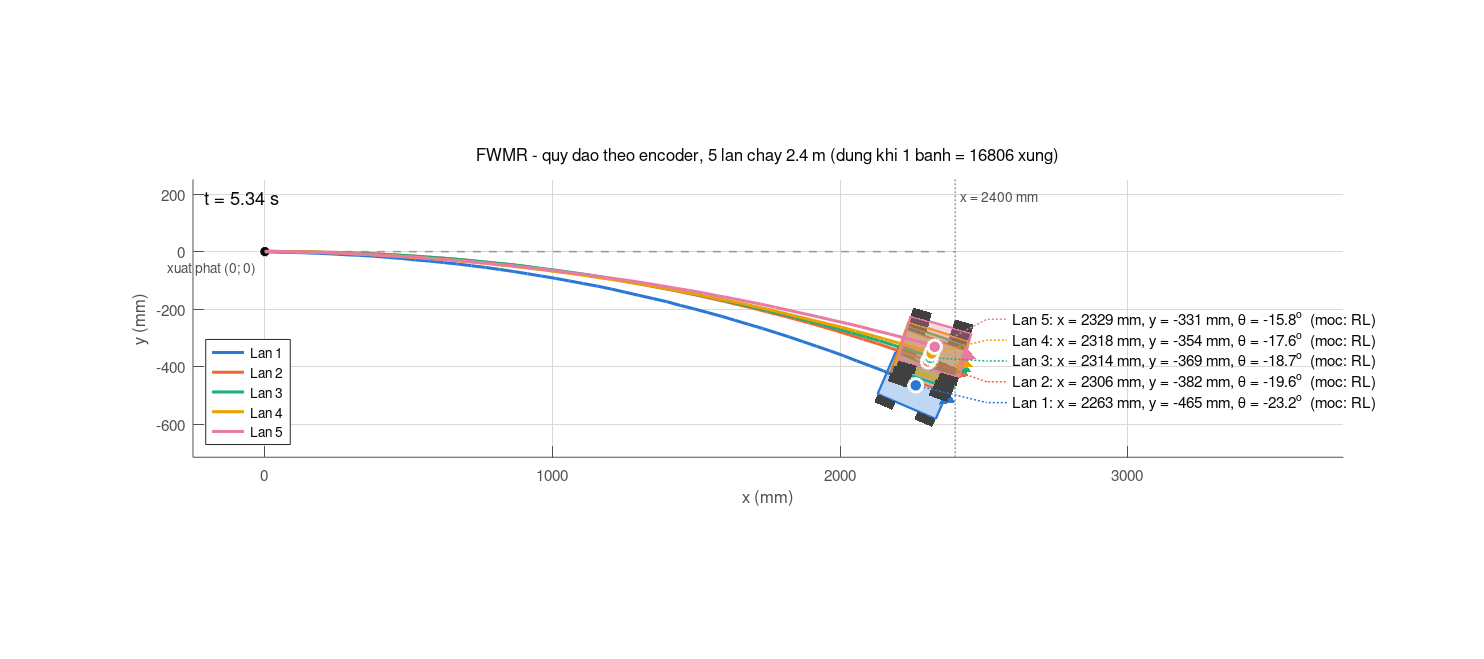
Claude outputs/fig1.png
