snepytago/Four-Wheel-Mecanum-Robot/Claude outputs/xem_truoc_quy_dao.png

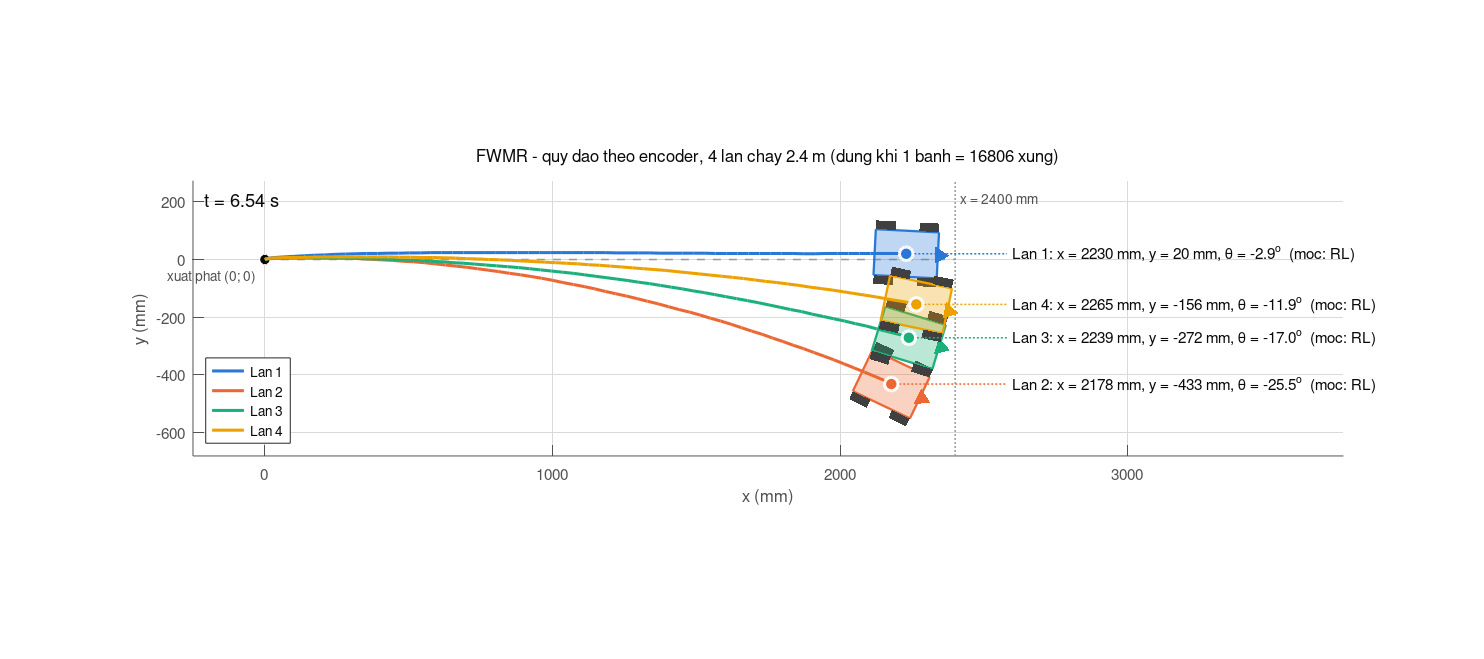
Claude outputs/xem_truoc_quy_dao.png
