snepytago/Four-Wheel-Mecanum-Robot/matlab_plot/ekf_lan_loi_camera.png

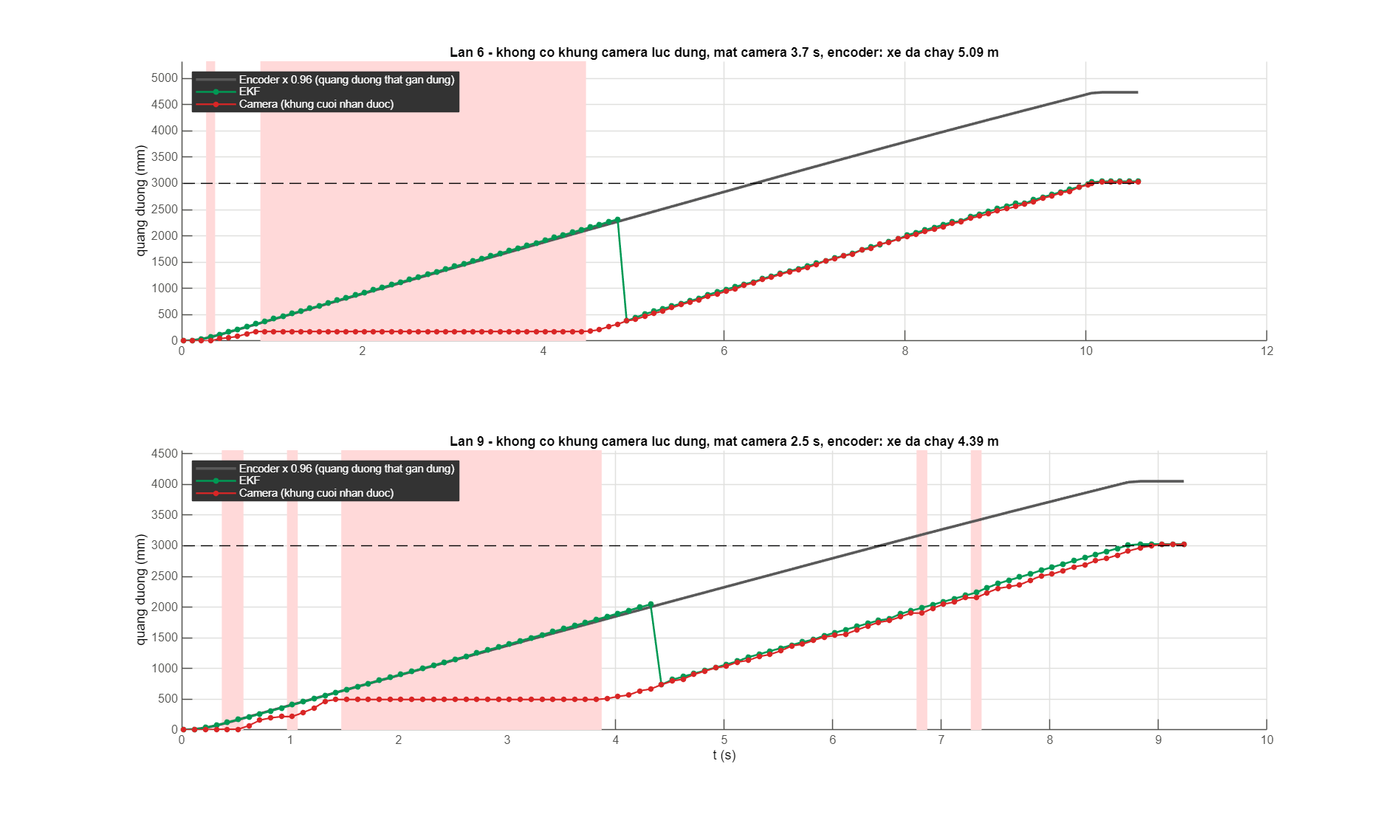
matlab_plot/ekf_lan_loi_camera.png
