snepytago/Four-Wheel-Mecanum-Robot/matlab_plot/ekf_so_sanh_chi_so.png

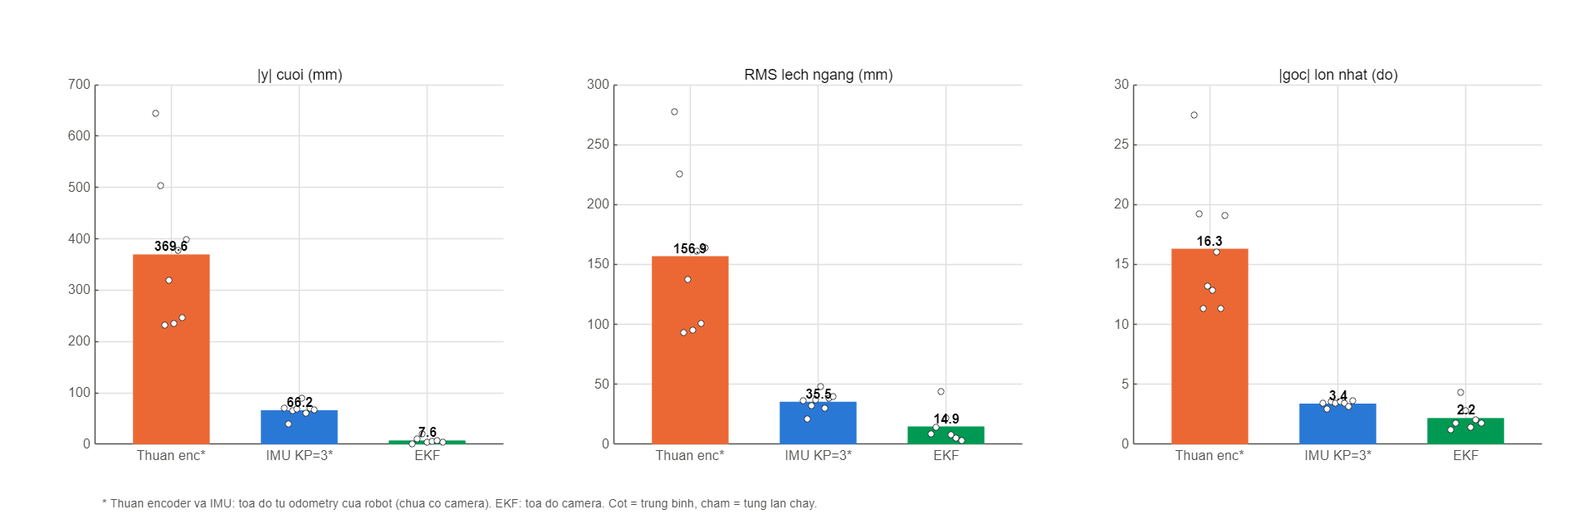
matlab_plot/ekf_so_sanh_chi_so.png
