snepytago/Four-Wheel-Mecanum-Robot/matlab_plot/ekf_so_sanh_quy_dao.png

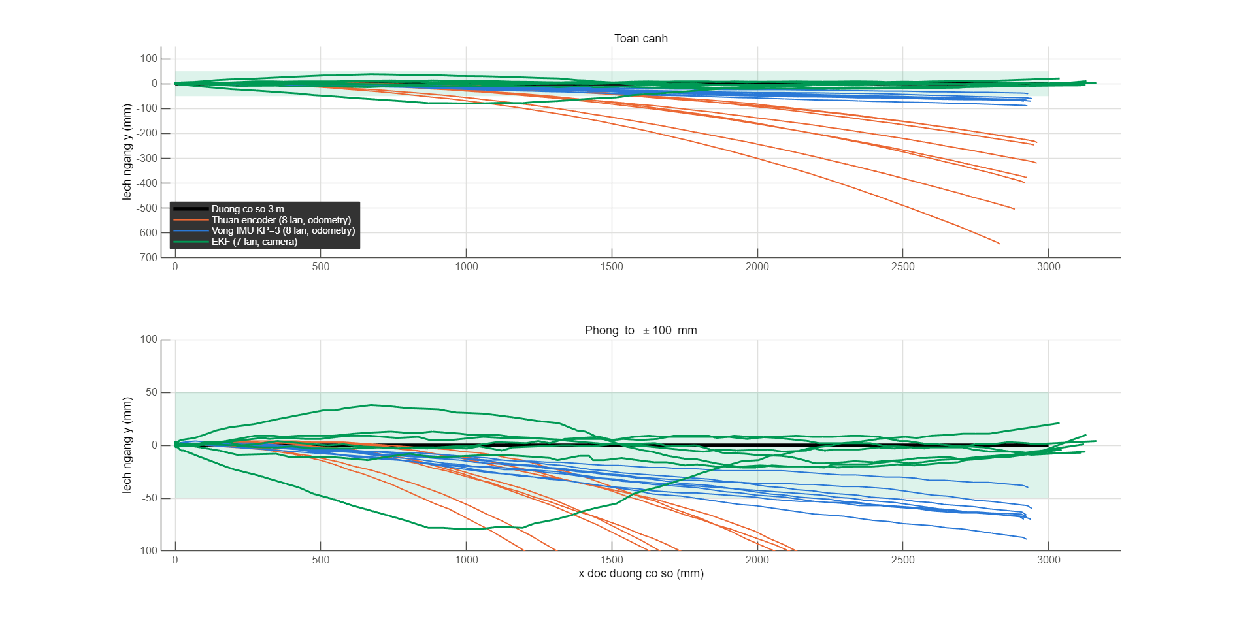
matlab_plot/ekf_so_sanh_quy_dao.png
