snepytago/Four-Wheel-Mecanum-Robot/matlab_plot/ekf_truoc_sau_sua.png

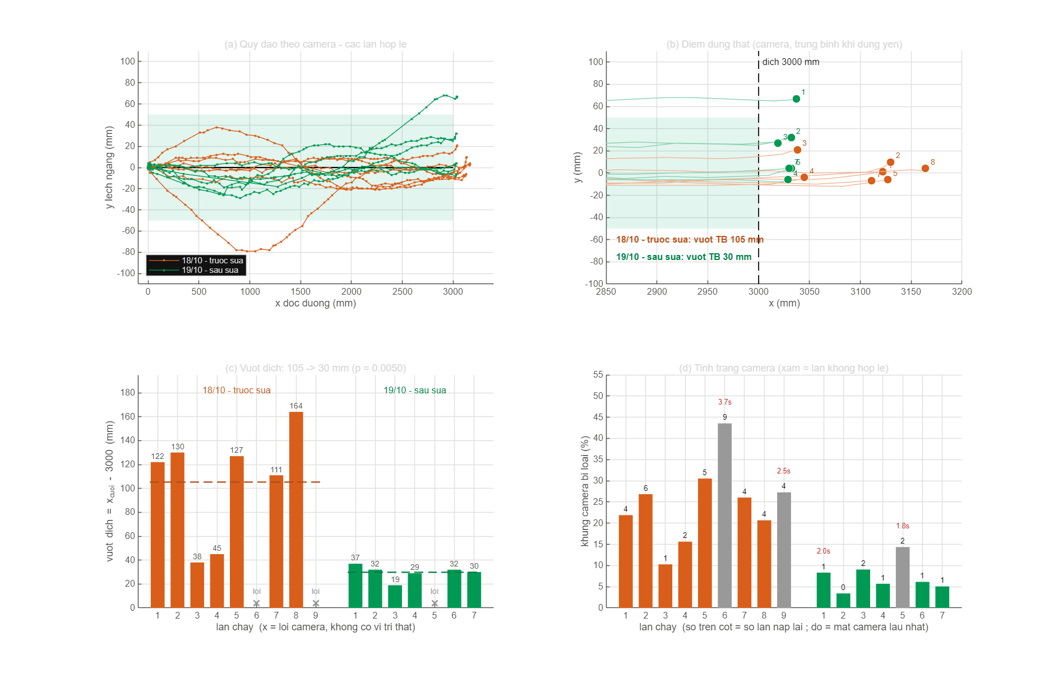
matlab_plot/ekf_truoc_sau_sua.png
