snepytago/Four-Wheel-Mecanum-Robot/matlab_plot/log_imu_kp3_07102026_yaw.png

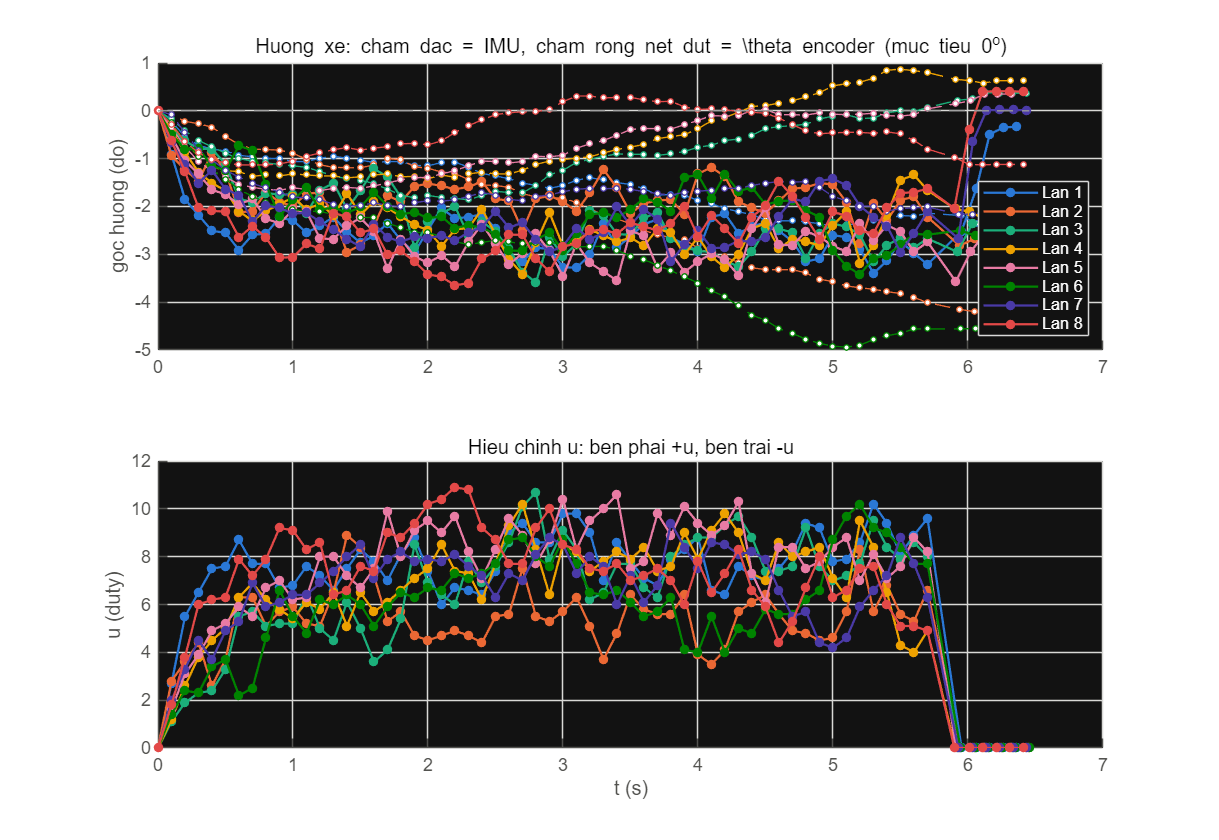
matlab_plot/log_imu_kp3_07102026_yaw.png
