snepytago/Four-Wheel-Mecanum-Robot/matlab_plot/log_zigzag_mode2_20102026_zigzag.png

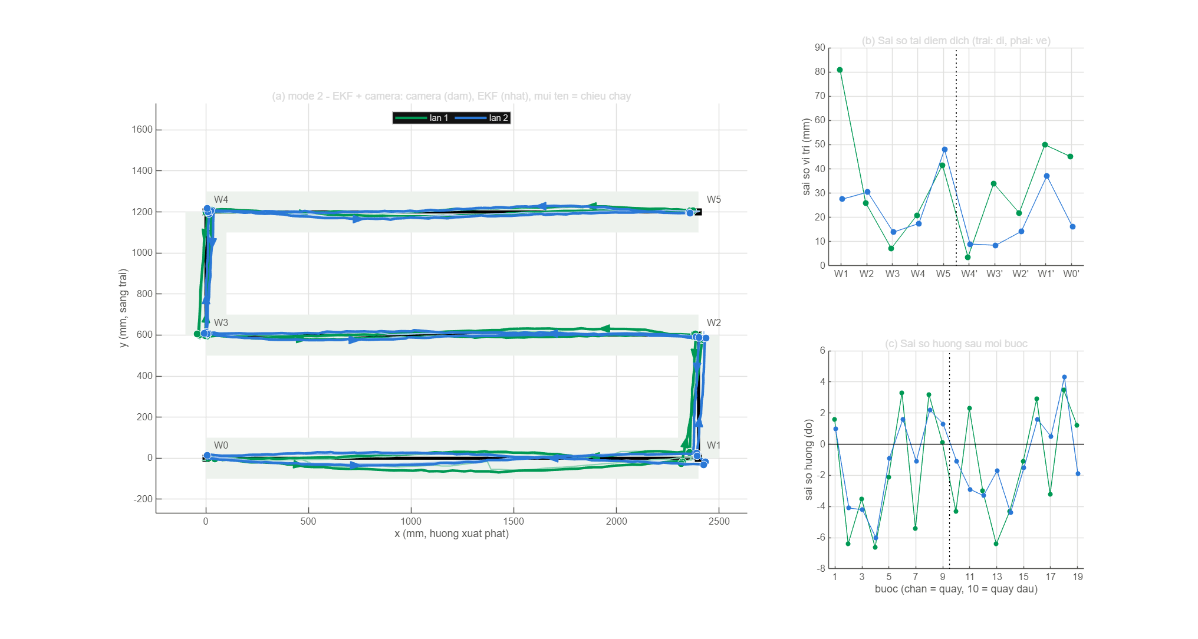
matlab_plot/log_zigzag_mode2_20102026_zigzag.png
