snepytago/Four-Wheel-Mecanum-Robot/matlab_plot/slide_ekf_9lan.png

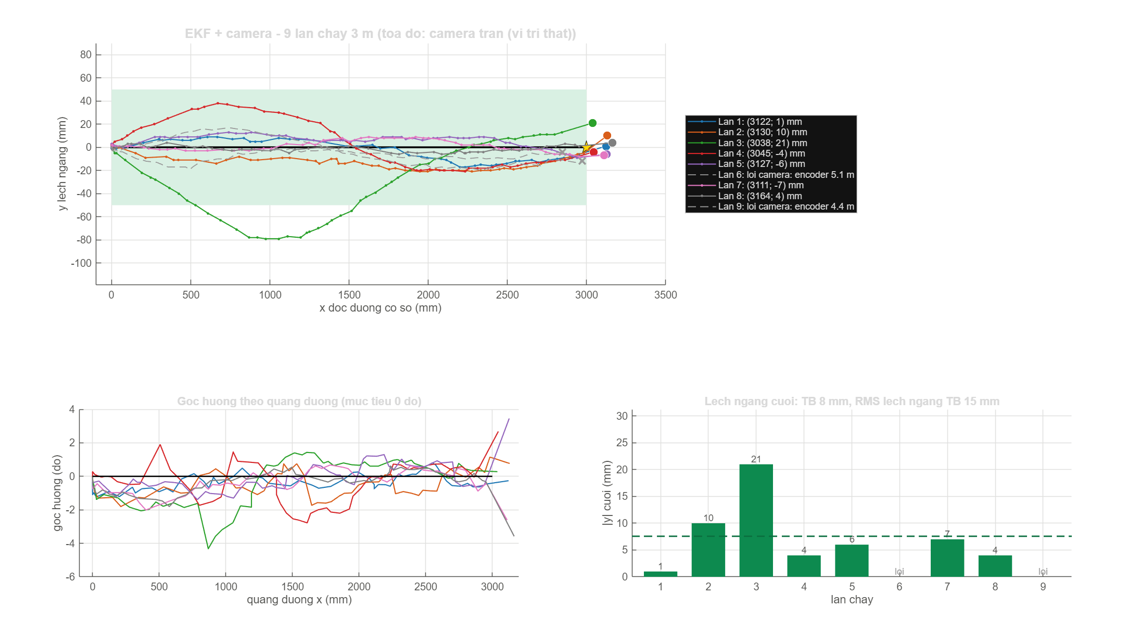
matlab_plot/slide_ekf_9lan.png
