snepytago/Four-Wheel-Mecanum-Robot/matlab_plot/slide_enc_8lan.png

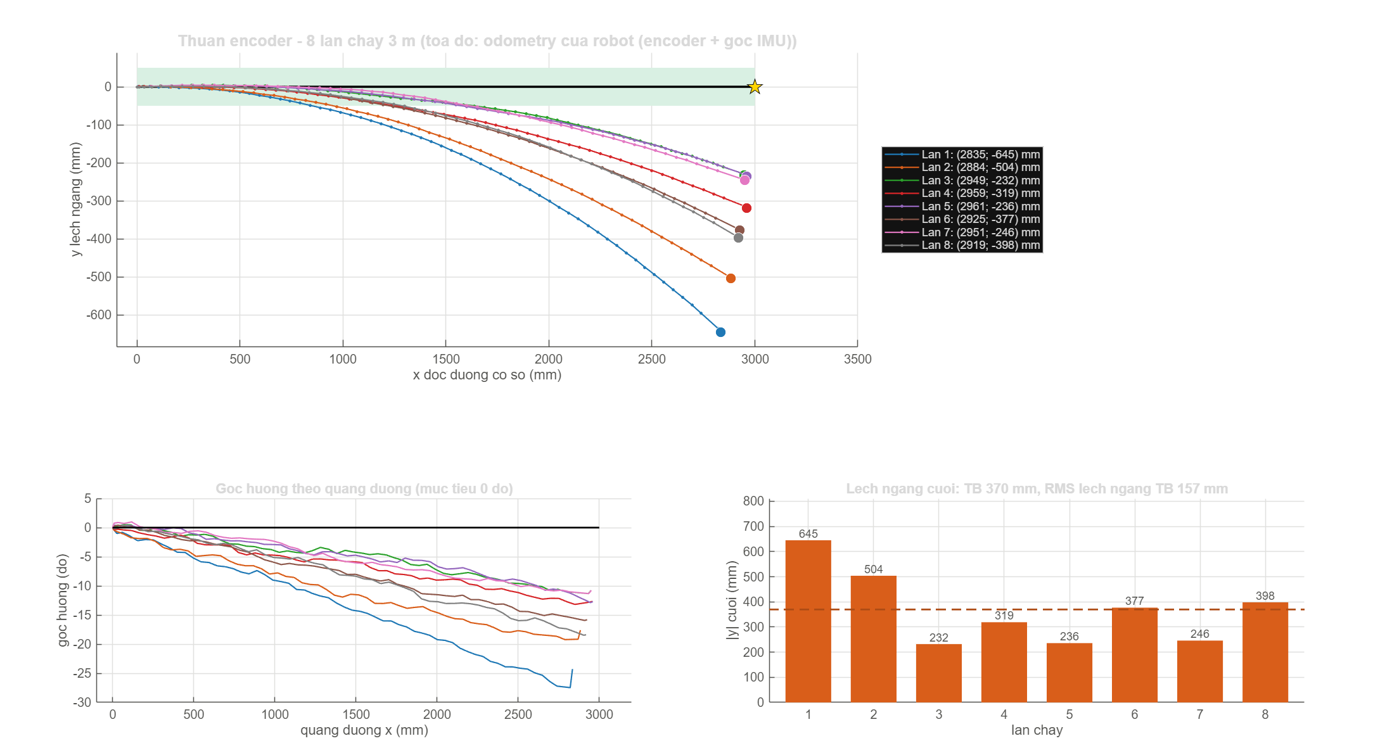
matlab_plot/slide_enc_8lan.png
