snepytago/Four-Wheel-Mecanum-Robot/matlab_plot/slide_imu_8lan.png

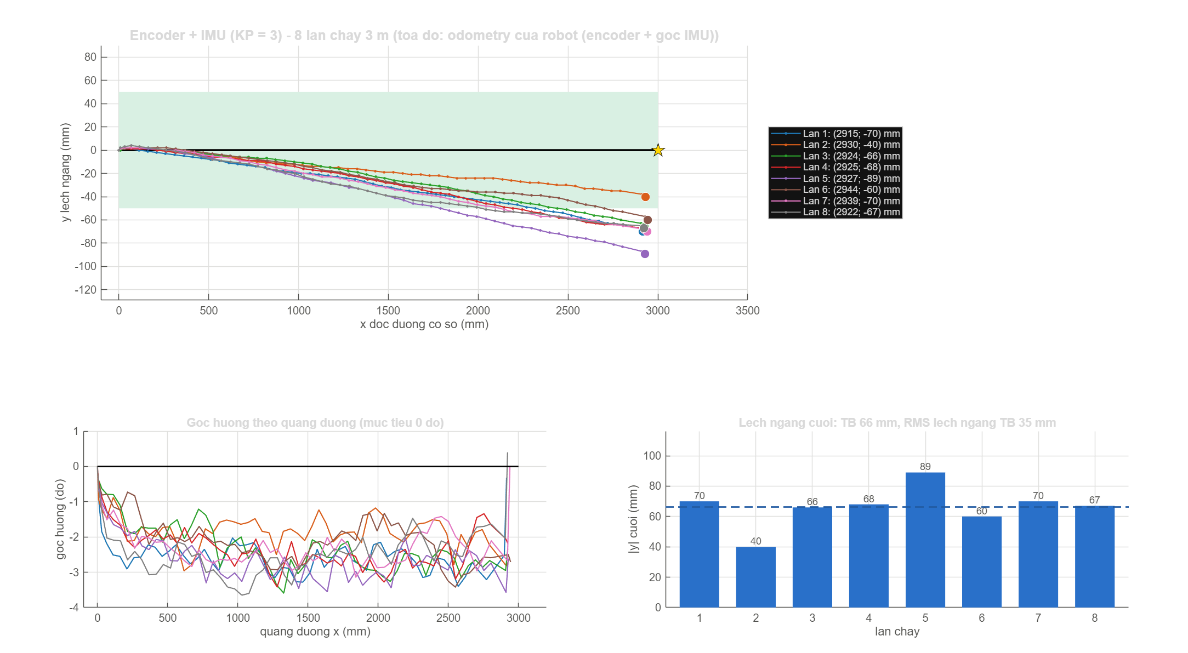
matlab_plot/slide_imu_8lan.png
