snepytago/Four-Wheel-Mecanum-Robot/matlab_plot/slide_so_sanh_tot_nhat.png

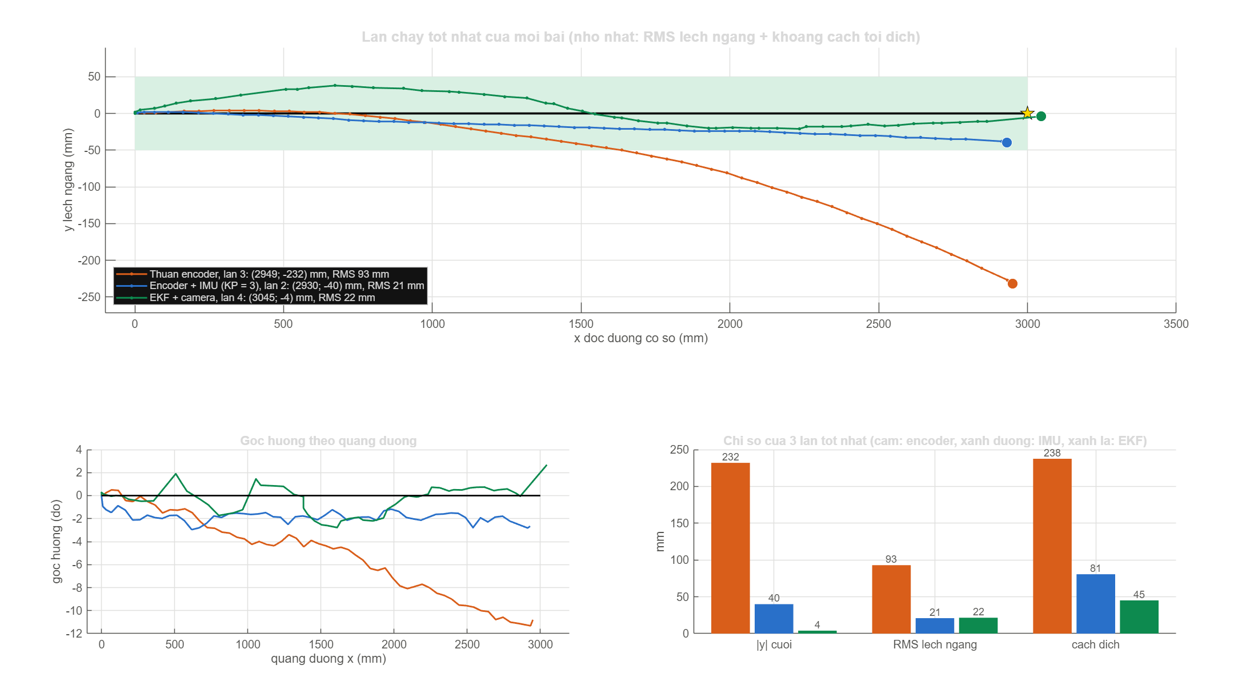
matlab_plot/slide_so_sanh_tot_nhat.png
