snepytago/Four-Wheel-Mecanum-Robot/matlab_plot/so_sanh_lan_1.png

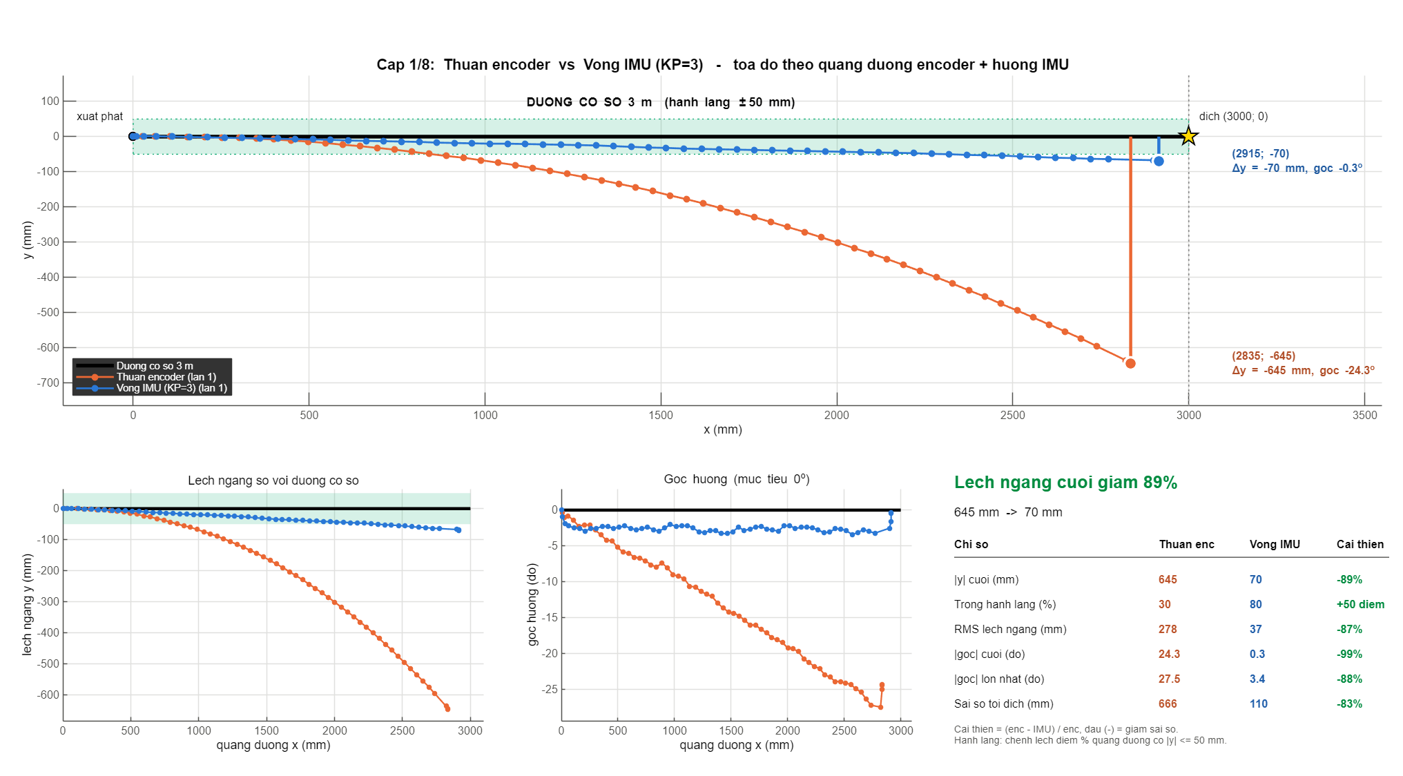
matlab_plot/so_sanh_lan_1.png
