snepytago/Four-Wheel-Mecanum-Robot/matlab_plot/so_sanh_tong_hop.png

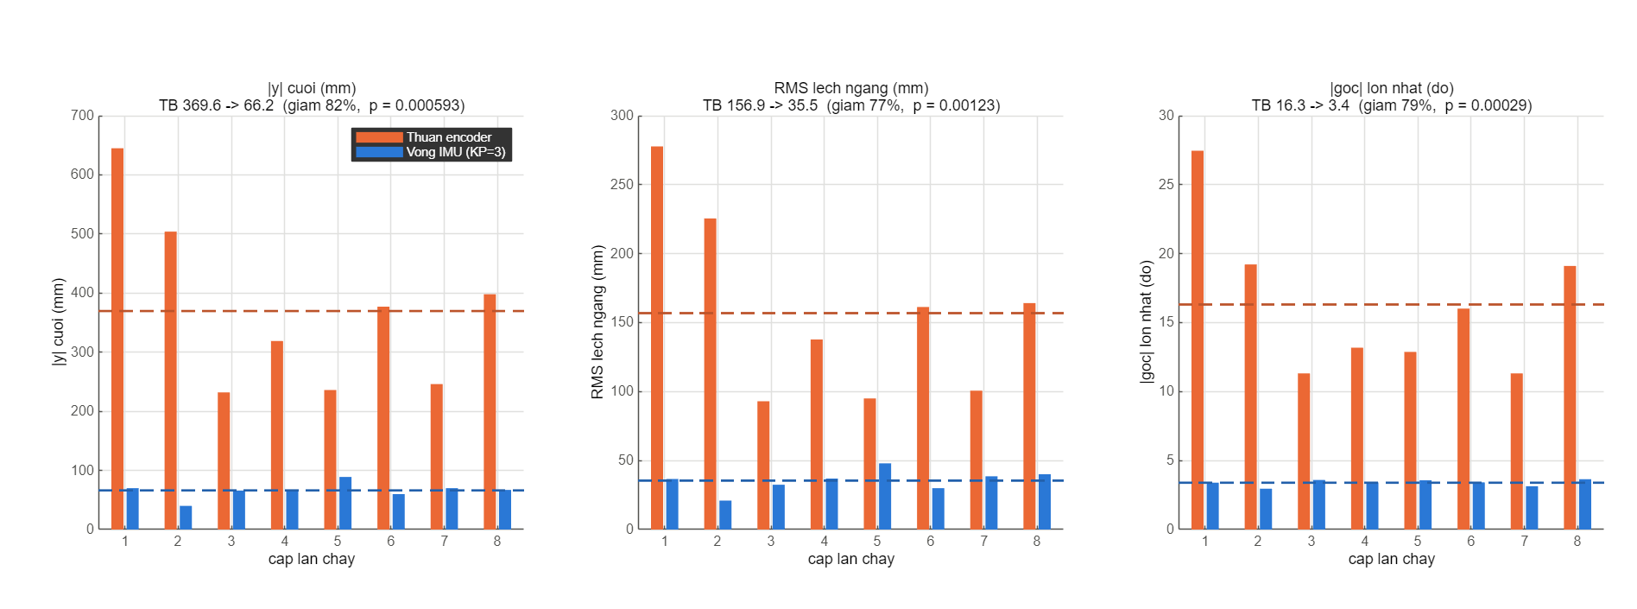
matlab_plot/so_sanh_tong_hop.png
