snepytago/Four-Wheel-Mecanum-Robot/matlab_plot/so_sanh_zigzag_3_phien_ban.png

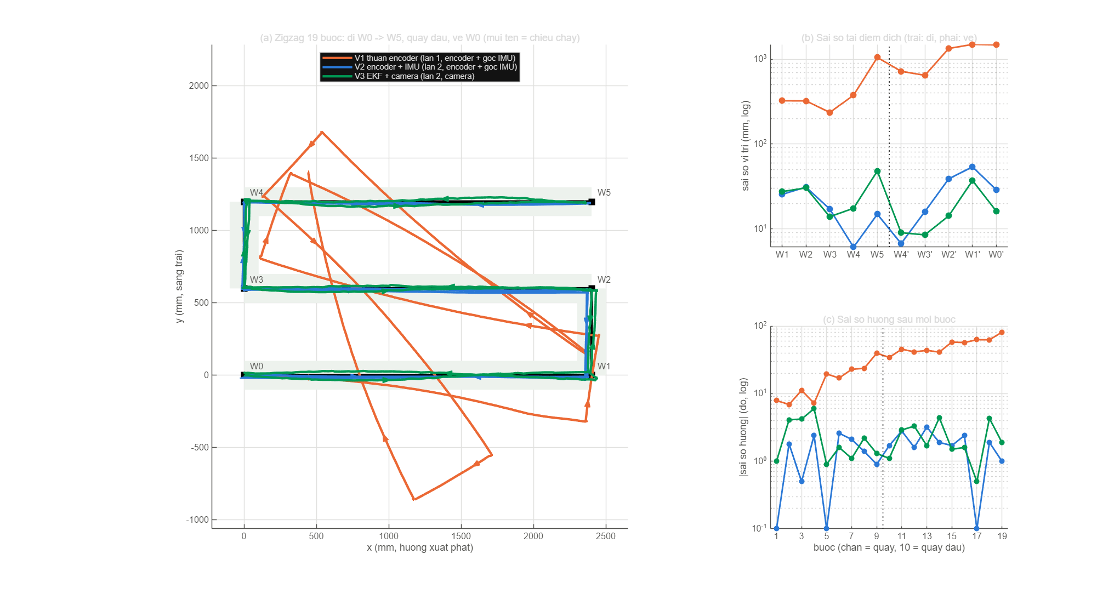
matlab_plot/so_sanh_zigzag_3_phien_ban.png
