snepytago/Four-Wheel-Mecanum-Robot/matlab_plot/strafe_thuan_encoder.png

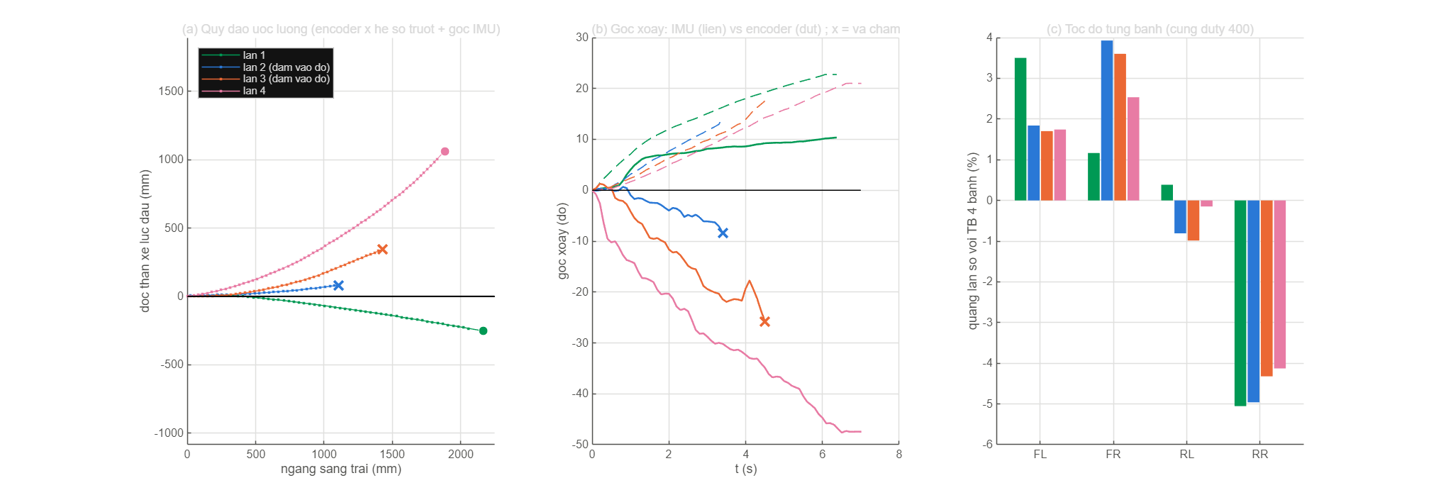
matlab_plot/strafe_thuan_encoder.png
