snepytago/Four-Wheel-Mecanum-Robot/matlab_plot/xem_truoc_xung_banh.png

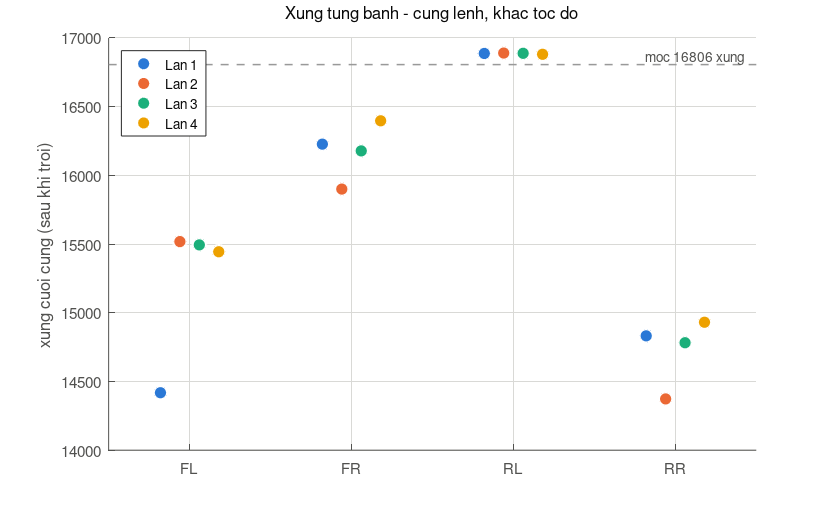
matlab_plot/xem_truoc_xung_banh.png
