snepytago/Four-Wheel-Mecanum-Robot/tests_luu_tru/goto_test.c.txt

#include "goto_test.h"
#include "config.h"
#include "ekf.h"
#include "encoder.h"
#include "kinematics.h"
#include "mpu6050.h"
#include "pose_link.h"
#include "robot_control.h"
#include "usart6.h"
#include "stm32f4xx_hal.h"
#include <math.h>

#define DEG2RAD  0.017453293f
#define RAD2DEG  57.29577951f

enum { ST_SETTLE = 0, ST_ROTATE, ST_DRIVE, ST_WAIT_CAM, ST_DONE };
enum { KQ_DAT = 0, KQ_CHUA_DAT, KQ_HET_GIO, KQ_STOP };

static const char *ST_NAME[] = { "DUNG", "XOAY", "CHAY", "CHO_CAM", "XONG" };

static uint8_t  st;
static uint8_t  moving;             // dang ra lenh chuyen dong (de nhan ra khung camera dong bang)
static uint32_t cam_good_ms;        // lan cuoi nhan 1 khung camera hop le
static float    cxp, cyp, cthp;     // khung camera truoc (so sanh dong bang)
static float    gz_prev;

static int32_t  cnt[4];             // xung luy ke tu luc xuat phat
static float    ox, oy, oth;        // odometry thuan (encoder + gyro, KHONG nhan camera) de so sanh
static uint16_t cam_nlog;           // so khung camera da tron vao EKF ke tu dong log truoc
static uint8_t  cam_new;            // co khung camera moi trong chu ky nay

// Trung binh camera luc dung yen (cho bang ket qua)
static float    av_x, av_y, av_s, av_c;
static uint32_t av_n;
static uint8_t  av_on;              // chi cong don trong cua so cuoi cua pha dung yen

static float wrap_pi(float a)
{
    while (a >  PI) a -= TWO_PI;
    while (a < -PI) a += TWO_PI;
    return a;
}

static void send_mm(float m)   { usart6_send_int((int32_t)lroundf(m * 1000.0f)); }
static void send_deg(float r)  { usart6_send_float(r * RAD2DEG, 1); }

static void stop_motors(void)  { robot_set_velocity(0.0f, 0.0f, 0.0f); }

// Toc do nho nhat de cap banh dang chay vuot nguong khoi dong, voi huong
// (a, b) trong he than xe (da chia K_SLIP). Theo IK: |w| = |vx -+ vy| / r.
static float v_floor_for(float a, float b)
{
    float p = fabsf(a - b);   // FL, RR
    float q = fabsf(a + b);   // FR, RL
    float kmax = (p > q) ? p : q;
    float kmin = (p < q) ? p : q;
    float k = (kmin > 0.3f * kmax) ? kmin : kmax;   // cap gan bang 0 (chay cheo 45 do) thi bo qua
    if (k < 1e-3f) return GOTO_V_MAX;
    float v = GOTO_WHEEL_MARGIN * MOTOR_OMEGA_MIN * WHEEL_R / k;
    return (v > GOTO_V_MAX) ? GOTO_V_MAX : v;
}

// Doc cam bien + chay EKF. Goi dung 1 lan moi CONTROL_DT_MS.
static void sense(float dt, uint32_t now)
{
    pose_link_poll();

    int32_t d[4];
    encoder_get_deltas(d);
    const float k = TWO_PI / COUNTS_PER_REV;
    float dxb, dyb, dwz;
    forward_kinematics(d[MOTOR_FL] * k, d[MOTOR_FR] * k, d[MOTOR_RL] * k, d[MOTOR_RR] * k,
                       &dxb, &dyb, &dwz);
    dxb *= K_SLIP_X;
    dyb *= K_SLIP_Y;
    for (int i = 0; i < 4; i++) cnt[i] += d[i];

    mpu6050_update(dt);
    float gz = mpu6050_get_gyro_z_dps();
    if (fabsf(gz) > GOTO_GZ_MAX_DPS) gz = gz_prev;   // gai nhieu / doc I2C loi
    gz_prev = gz;

    ekf_predict(dxb, dyb, gz * DEG2RAD, dt, now);

    float om = oth + 0.5f * gz * DEG2RAD * dt;
    ox += cosf(om) * dxb - sinf(om) * dyb;
    oy += sinf(om) * dxb + cosf(om) * dyb;
    oth = wrap_pi(oth + gz * DEG2RAD * dt);

    cam_new = 0;

    if (pose_link_take_fresh()) {
        float xc = pose_link_get_x(), yc = pose_link_get_y();
        float thc = pose_link_get_theta_deg() * DEG2RAD;
        uint8_t same = (xc == cxp && yc == cyp && thc == cthp);
        cxp = xc; cyp = yc; cthp = thc;

        // Mat marker thi phia PC gui lai pose cu. Khi xe dang chay, 2 khung
        // giong het nhau la khong the -> bo qua.
        if (!(same && moving)) {
            cam_good_ms = now;
            ekf_update_cam(xc, yc, thc, now - EKF_CAM_DELAY_MS);
            cam_nlog++;
            cam_new = 1;
            if (av_on) {
                av_x += xc; av_y += yc; av_s += sinf(thc); av_c += cosf(thc); av_n++;
            }
        }
    }
}

static void avg_reset(void) { av_x = av_y = av_s = av_c = 0.0f; av_n = 0; av_on = 0; }
static void avg_start(void) { avg_reset(); av_on = 1; }

static void go_state(uint8_t s, uint32_t t)
{
    st = s;
    moving = (s == ST_ROTATE || s == ST_DRIVE);
    if (!moving) stop_motors();
    avg_reset();
    usart6_send_string("GOTO:");
    usart6_send_string(ST_NAME[s]);
    usart6_send_string(" t_ms=");
    usart6_send_int((int32_t)t);
    usart6_send_string(" x=");  send_mm(ekf_x());
    usart6_send_string(" y=");  send_mm(ekf_y());
    usart6_send_string(" th="); send_deg(ekf_th());
    usart6_send_string("\r\n");
}

void goto_test_run(uint8_t imu_ready)
{
    stop_motors();

    if (!imu_ready) {
        while (1) {
            usart6_send_string("GOTO:LOI - khong thay MPU6050, khong chay\r\n");
            HAL_Delay(2000);
        }
    }

    const float gx = GOTO_GOAL_X_CM * 0.01f;
    const float gy = GOTO_GOAL_Y_CM * 0.01f;

    usart6_send_string("GOTO:DICH x=");  send_mm(gx);
    usart6_send_string(" mm y=");        send_mm(gy);
    usart6_send_string(" mm\r\n");

    // ---------- 1. Cho camera, trung binh GOTO_INIT_FRAMES khung ----------
    uint32_t last = HAL_GetTick(), last_msg = last;
    float sx = 0.0f, sy = 0.0f, ss = 0.0f, sc = 0.0f;
    uint32_t n = 0;
    while (n < GOTO_INIT_FRAMES) {
        uint32_t now = HAL_GetTick();
        if ((now - last) < CONTROL_DT_MS) continue;
        float dt = (float)(now - last) / 1000.0f;
        last = now;

        pose_link_poll();
        int32_t d[4];
        encoder_get_deltas(d);
        mpu6050_update(dt);

        if (pose_link_take_fresh()) {
            float th = pose_link_get_theta_deg() * DEG2RAD;
            sx += pose_link_get_x(); sy += pose_link_get_y();
            ss += sinf(th);          sc += cosf(th);
            n++;
        }
        if ((now - last_msg) >= 1000u) {
            last_msg = now;
            usart6_send_string("GOTO:CHO_CAMERA so_khung=");
            usart6_send_int((int32_t)n);
            usart6_send_string("\r\n");
        }
    }
    const float x0 = sx / (float)n, y0 = sy / (float)n, th0 = atan2f(ss, sc);
    ekf_init(x0, y0, th0, HAL_GetTick());
    cxp = cyp = cthp = 1e9f;
    gz_prev = 0.0f;
    ox = x0; oy = y0; oth = th0;

    usart6_send_string("GOTO:XUAT_PHAT x="); send_mm(x0);
    usart6_send_string(" y=");               send_mm(y0);
    usart6_send_string(" th=");              send_deg(th0);
    usart6_send_string("\r\n");

    // ---------- 2. Dem nguoc, xe dung yen: EKF hoc bias ----------
    uint32_t t_cd = HAL_GetTick();
    last = t_cd; last_msg = t_cd - 1000u;
    st = ST_SETTLE; moving = 0;
    while ((HAL_GetTick() - t_cd) < GOTO_START_DELAY_MS) {
        uint32_t now = HAL_GetTick();
        if ((now - last) < CONTROL_DT_MS) continue;
        float dt = (float)(now - last) / 1000.0f;
        last = now;
        sense(dt, now);
        if ((now - last_msg) >= 1000u) {
            last_msg = now;
            usart6_send_string("GOTO:DEM_NGUOC ");
            usart6_send_int((int32_t)((GOTO_START_DELAY_MS - (now - t_cd) + 999u) / 1000u));
            usart6_send_string("\r\n");
        }
    }

    // Huong chay va huong cuoi
    float d0 = hypotf(gx - ekf_x(), gy - ekf_y());
    float th_goal = ekf_th();
#if GOTO_FACE_GOAL
    if (d0 > GOTO_POS_TOL_M) th_goal = atan2f(gy - ekf_y(), gx - ekf_x());
#endif
    usart6_send_string("GOTO:HUONG_CHAY="); send_deg(th_goal);
    usart6_send_string(" do  quang_duong="); send_mm(d0);
    usart6_send_string(" mm\r\n");

    // Duong thang co so S -> G (S = vi tri EKF luc bat dau chay)
    const float xs = ekf_x(), ys = ekf_y();
    const float ux = (d0 > 1e-6f) ? (gx - xs) / d0 : 1.0f;
    const float uy = (d0 > 1e-6f) ? (gy - ys) / d0 : 0.0f;
    float cr_max = 0.0f, cr_s2 = 0.0f, cr_len = 0.0f, cr_cam_max = 0.0f;
    float al_prev = 0.0f;

    for (int i = 0; i < 4; i++) cnt[i] = 0;
    cam_nlog = 0;
    usart6_send_string("GT,t_ms,trang_thai,FL,FR,RL,RR,x_mm,y_mm,th_deg,xc_mm,yc_mm,thc_deg,cam,"
                       "xo_mm,yo_mm,tho_deg,gz_dps,v,wz,dist_mm,lech_mm\r\n");

    // ---------- 3. Chay ----------
    const uint32_t t0 = HAL_GetTick();
    uint32_t t_st = 0, last_print = t0;
    uint8_t  kq = KQ_DAT;
    uint16_t tries = 0;
    uint32_t n_resnap = 0;
    float    v_prev = 0.0f, dist_min = 1e9f, e_prev = 0.0f;
    float    v_out = 0.0f, wz_out = 0.0f;
    last = t0;
    cam_good_ms = t0;
    avg_reset();
    go_state(ST_SETTLE, 0);
    t_st = 0;

    while (st != ST_DONE) {
        uint32_t now = HAL_GetTick();
        if ((now - last) < CONTROL_DT_MS) continue;
        float dt = (float)(now - last) / 1000.0f;
        last = now;
        uint32_t t = now - t0;

        sense(dt, now);

        float x = ekf_x(), y = ekf_y(), th = ekf_th();
        float ex = gx - x, ey = gy - y;
        float dist = hypotf(ex, ey);
        float eth = wrap_pi(th_goal - th);
        v_out = 0.0f; wz_out = 0.0f;

        // Lech ngang so voi duong S -> G (duong = ben trai), tinh khi dang chay
        float cr = ux * (y - ys) - uy * (x - xs);
        float al = ux * (x - xs) + uy * (y - ys);
        if (st == ST_DRIVE) {
            float dal = fabsf(al - al_prev);
            if (fabsf(cr) > cr_max) cr_max = fabsf(cr);
            cr_s2  += cr * cr * dal;
            cr_len += dal;
            if (cam_new) {
                float crc = ux * (pose_link_get_y() - ys) - uy * (pose_link_get_x() - xs);
                if (fabsf(crc) > cr_cam_max) cr_cam_max = fabsf(crc);
            }
        }
        al_prev = al;

        if (pose_link_take_stop()) { kq = KQ_STOP;    go_state(ST_DONE, t); break; }
        if (t > GOTO_TIMEOUT_MS)   { kq = KQ_HET_GIO; go_state(ST_DONE, t); break; }

        if (moving && (now - cam_good_ms) > GOTO_CAM_LOST_MS) {
            go_state(ST_WAIT_CAM, t); t_st = t;
        }

        switch (st) {
        case ST_WAIT_CAM:
            if ((now - cam_good_ms) < CONTROL_DT_MS * 2u) { go_state(ST_SETTLE, t); t_st = t; }
            break;

        case ST_SETTLE:
            if (!av_on && av_n == 0 && (t - t_st) >= GOTO_SETTLE_MS - GOTO_SETTLE_AVG_MS) avg_start();
            if ((t - t_st) < GOTO_SETTLE_MS) break;
            // Xe dung yen du lau -> camera khong con tre: neu EKF lech trung binh
            // camera thi tin camera (EKF co the sai khi do tre dat chua dung).
            if (av_n >= 3) {
                float ax = av_x / (float)av_n, ay = av_y / (float)av_n, ath = atan2f(av_s, av_c);
                if (hypotf(ax - x, ay - y) > GOTO_RESNAP_M ||
                    fabsf(wrap_pi(ath - th)) > GOTO_RESNAP_DEG * DEG2RAD) {
                    ekf_set_pose(ax, ay, ath, now);
                    n_resnap++;
                }
                x = ax; y = ay; th = ath;
                ex = gx - x; ey = gy - y;
                dist = hypotf(ex, ey);
                eth = wrap_pi(th_goal - th);
            }
            av_on = 0;
            if (dist > GOTO_POS_TOL_M) {
                if (tries >= GOTO_MAX_TRIES) { kq = KQ_CHUA_DAT; go_state(ST_DONE, t); break; }
                tries++;
                if (GOTO_FACE_GOAL && fabsf(eth) > GOTO_TH_GO_DEG * DEG2RAD) {
                    e_prev = eth; go_state(ST_ROTATE, t);
                } else {
                    v_prev = 0.0f; dist_min = dist; go_state(ST_DRIVE, t);
                }
            } else if (fabsf(eth) > GOTO_TH_TOL_DEG * DEG2RAD) {
                if (tries >= GOTO_MAX_TRIES) { kq = KQ_CHUA_DAT; go_state(ST_DONE, t); break; }
                tries++;
                e_prev = eth; go_state(ST_ROTATE, t);
            } else {
                kq = KQ_DAT; go_state(ST_DONE, t);
            }
            t_st = t;
            break;

        case ST_ROTATE: {
            // Dung khi du gan hoac vua vuot qua dich (doi dau)
            if (fabsf(eth) < GOTO_TH_TOL_DEG * DEG2RAD || (eth * e_prev) < 0.0f ||
                (t - t_st) > GOTO_ROTATE_MAX_MS) {
                go_state(ST_SETTLE, t); t_st = t;
                break;
            }
            e_prev = eth;
            float w = GOTO_KP_TH_ROT * fabsf(eth);
            if (w < GOTO_WZ_MIN) w = GOTO_WZ_MIN;
            if (w > GOTO_WZ_MAX) w = GOTO_WZ_MAX;
            wz_out = (eth > 0.0f) ? w : -w;
            robot_set_velocity(0.0f, 0.0f, wz_out);
            break;
        }

        case ST_DRIVE: {
            if (dist < dist_min) dist_min = dist;
            if (dist < GOTO_STOP_M || dist > dist_min + GOTO_OVERSHOOT_M) {
                go_state(ST_SETTLE, t); t_st = t;
                break;
            }
            float c = cosf(th), s = sinf(th);
            float uxw = ex / dist, uyw = ey / dist;
            float uxb = ( uxw * c + uyw * s) / K_SLIP_X;   // lenh = do doi mong muon / ti le truot
            float uyb = (-uxw * s + uyw * c) / K_SLIP_Y;

            float v = GOTO_KP_POS * dist;
            if (v > GOTO_V_MAX) v = GOTO_V_MAX;
            float vr = v_prev + GOTO_ACCEL * dt;
            if (v > vr) v = vr;
            float vf = v_floor_for(uxb, uyb);
            if (v < vf) v = vf;
            v_prev = v;
            v_out = v;

            float wz = GOTO_KP_TH_DRIVE * eth;
            if (wz >  GOTO_WZ_MAX_DRIVE) wz =  GOTO_WZ_MAX_DRIVE;
            if (wz < -GOTO_WZ_MAX_DRIVE) wz = -GOTO_WZ_MAX_DRIVE;

            wz_out = wz;
            robot_set_velocity(v * uxb, v * uyb, wz);
            break;
        }
        }

        if ((now - last_print) >= GOTO_LOG_EVERY_MS) {
            last_print = now;
            usart6_send_string("GT,");
            usart6_send_int((int32_t)t);          usart6_send_char(',');
            usart6_send_string(ST_NAME[st]);
            for (int i = 0; i < 4; i++) { usart6_send_char(','); usart6_send_int(cnt[i]); }
            usart6_send_char(',');
            send_mm(x);                           usart6_send_char(',');
            send_mm(y);                           usart6_send_char(',');
            send_deg(th);                         usart6_send_char(',');
            send_mm(pose_link_get_x());           usart6_send_char(',');
            send_mm(pose_link_get_y());           usart6_send_char(',');
            usart6_send_float(pose_link_get_theta_deg(), 1); usart6_send_char(',');
            usart6_send_int(cam_nlog);            usart6_send_char(',');
            send_mm(ox);                          usart6_send_char(',');
            send_mm(oy);                          usart6_send_char(',');
            send_deg(oth);                        usart6_send_char(',');
            usart6_send_float(gz_prev, 2);        usart6_send_char(',');
            usart6_send_float(v_out, 3);          usart6_send_char(',');
            usart6_send_float(wz_out, 2);         usart6_send_char(',');
            send_mm(dist);                        usart6_send_char(',');
            send_mm(cr);
            usart6_send_string("\r\n");
            cam_nlog = 0;
        }
    }

    stop_motors();
    moving = 0;
    const uint32_t t_end = HAL_GetTick() - t0;

    // Cho xe dung han + camera bat kip, lay trung binh camera lam ket qua
    avg_reset();
    uint32_t t_w = HAL_GetTick();
    last = t_w;
    while ((HAL_GetTick() - t_w) < GOTO_SETTLE_MS) {
        uint32_t now = HAL_GetTick();
        if ((now - last) < CONTROL_DT_MS) continue;
        float dt = (float)(now - last) / 1000.0f;
        last = now;
        if (!av_on && (now - t_w) >= GOTO_SETTLE_MS - GOTO_SETTLE_AVG_MS) avg_start();
        sense(dt, now);
    }
    float fx = ekf_x(), fy = ekf_y(), fth = ekf_th();
    uint8_t cam_ok = (av_n > 0);
    float cx = cam_ok ? av_x / (float)av_n : pose_link_get_x();
    float cy = cam_ok ? av_y / (float)av_n : pose_link_get_y();
    float cth = cam_ok ? atan2f(av_s, av_c) : pose_link_get_theta_deg() * DEG2RAD;
    float err_xy = hypotf(gx - cx, gy - cy);
    float cr_end = ux * (cy - ys) - uy * (cx - xs);
    float cr_rms = (cr_len > 1e-3f) ? sqrtf(cr_s2 / cr_len) : 0.0f;
    float odo_err = hypotf(ox - cx, oy - cy);
    float err_th = wrap_pi(th_goal - cth);

    while (1) {
        usart6_send_string("===== GOTO KET QUA =====\r\n");
        usart6_send_string("ket_qua: ");
        switch (kq) {
            case KQ_DAT:      usart6_send_string("DAT");           break;
            case KQ_CHUA_DAT: usart6_send_string("CHUA_DAT (het so lan dieu chinh)"); break;
            case KQ_HET_GIO:  usart6_send_string("HET_GIO");       break;
            default:          usart6_send_string("DUNG_BOI_STOP"); break;
        }
        usart6_send_string("\r\ndich:            x="); send_mm(gx);
        usart6_send_string(" mm  y=");                send_mm(gy);
        usart6_send_string(" mm  huong=");            send_deg(th_goal);
        usart6_send_string(" do\r\nxuat_phat:       x="); send_mm(x0);
        usart6_send_string(" mm  y=");                send_mm(y0);
        usart6_send_string(" mm  th=");               send_deg(th0);
        usart6_send_string(" do\r\nduong_co_so:     dai="); send_mm(d0);
        usart6_send_string(" mm  huong=");            send_deg(th_goal);
        usart6_send_string(" do\r\ncuoi_camera:     x="); send_mm(cx);
        usart6_send_string(" mm  y=");                send_mm(cy);
        usart6_send_string(" mm  th=");               send_deg(cth);
        usart6_send_string(cam_ok ? " do  (trung binh khi dung yen)\r\n" : " do  (KHONG co khung moi!)\r\n");
        usart6_send_string("cuoi_ekf:        x=");    send_mm(fx);
        usart6_send_string(" mm  y=");                send_mm(fy);
        usart6_send_string(" mm  th=");               send_deg(fth);
        usart6_send_string(" do\r\ncuoi_odo_thuan:  x="); send_mm(ox);
        usart6_send_string(" mm  y=");                send_mm(oy);
        usart6_send_string(" mm  th=");               send_deg(oth);
        usart6_send_string(" do  lech_so_voi_camera="); send_mm(odo_err);
        usart6_send_string(" mm\r\nxung_cuoi_cung:  FL="); usart6_send_int(cnt[0]);
        usart6_send_string(" FR=");                   usart6_send_int(cnt[1]);
        usart6_send_string(" RL=");                   usart6_send_int(cnt[2]);
        usart6_send_string(" RR=");                   usart6_send_int(cnt[3]);
        usart6_send_string("\r\nlech_ngang:      max_ekf="); send_mm(cr_max);
        usart6_send_string(" mm  rms_ekf=");          send_mm(cr_rms);
        usart6_send_string(" mm  max_camera=");       send_mm(cr_cam_max);
        usart6_send_string(" mm  cuoi_camera=");      send_mm(cr_end);
        usart6_send_string(" mm\r\nsai_so (camera): vi_tri="); send_mm(err_xy);
        usart6_send_string(" mm  huong=");            send_deg(err_th);
        usart6_send_string(" do\r\nthoi_gian_ms=");   usart6_send_int((int32_t)t_end);
        usart6_send_string("  so_lan_dieu_chinh="); usart6_send_int(tries);
        usart6_send_string("\r\nekf: bias=");         usart6_send_float(ekf_bias() * RAD2DEG, 3);
        usart6_send_string(" do/s  khung_nhan=");     usart6_send_int((int32_t)ekf_n_ok());
        usart6_send_string("  khung_loai=");          usart6_send_int((int32_t)ekf_n_reject());
        usart6_send_string("  nap_lai=");             usart6_send_int((int32_t)ekf_n_reset());
        usart6_send_string("  chinh_theo_cam_dung_yen="); usart6_send_int((int32_t)n_resnap);
        usart6_send_string("\r\n");
        HAL_Delay(5000);
    }
}
