snepytago/Four-Wheel-Mecanum-Robot/Core/Src/motor.c

#include "motor.h"
#include "config.h"
#include "stm32f4xx.h"
#include <math.h>

// duty = OFFSET[banh] + K_FF*|w| - moi banh mot offset rieng vi nguong
// khoi dong cua 4 dong co lech nhau (xem config.h).
static const float DUTY_OFFSET[4] = {
    MOTOR_DUTY_OFFSET_FL,
    MOTOR_DUTY_OFFSET_FR,
    MOTOR_DUTY_OFFSET_RL,
    MOTOR_DUTY_OFFSET_RR
};

static uint32_t speed_to_duty(motor_id_t wheel, float speed_rad_s)
{
    float w = fabsf(speed_rad_s);

    if (w < 1e-3f) return 0;   // lenh dung han -> cat PWM, khong de offset lam u dong co

    float duty = DUTY_OFFSET[wheel] + K_FF * w;

    if (duty > (float)(PWM_MAX - 1)) duty = (float)(PWM_MAX - 1);
    if (duty < 0.0f)                 duty = 0.0f;

    return (uint32_t)(duty + 0.5f);
}

static void pwm_pins_init(void)
{
    RCC->AHB1ENR |= RCC_AHB1ENR_GPIOAEN;

    // PA8-PA11 -> AF mode
    GPIOA->MODER &= ~((3u<<16)|(3u<<18)|(3u<<20)|(3u<<22));
    GPIOA->MODER |=  ((2u<<16)|(2u<<18)|(2u<<20)|(2u<<22));

    // AF1 = TIM1 cho ca 4 chan
    GPIOA->AFR[1] &= ~((0xFu<<0)|(0xFu<<4)|(0xFu<<8)|(0xFu<<12));
    GPIOA->AFR[1] |=  ((1u<<0)|(1u<<4)|(1u<<8)|(1u<<12));
}

static void timer1_init(void)
{
    RCC->APB2ENR |= RCC_APB2ENR_TIM1EN;

    TIM1->PSC = 0;
    TIM1->ARR = PWM_MAX - 1;

    TIM1->CCMR1 = (6u<<4)  | TIM_CCMR1_OC1PE
                | (6u<<12) | TIM_CCMR1_OC2PE;
    TIM1->CCMR2 = (6u<<4)  | TIM_CCMR2_OC3PE
                | (6u<<12) | TIM_CCMR2_OC4PE;

    TIM1->CCER = TIM_CCER_CC1E | TIM_CCER_CC2E | TIM_CCER_CC3E | TIM_CCER_CC4E;
    TIM1->CCR1 = 0; TIM1->CCR2 = 0; TIM1->CCR3 = 0; TIM1->CCR4 = 0;

    TIM1->BDTR |= TIM_BDTR_MOE;   // bat buoc voi advanced timer, khong co thi chan khong ra xung
    TIM1->EGR   = TIM_EGR_UG;
    TIM1->CR1   = TIM_CR1_ARPE | TIM_CR1_CEN;
}

void motor_init(void)
{
    pwm_pins_init();
    timer1_init();
    GPIOA->BSRR = (1u<<5);   // STBY = PA5, mo driver (MODER da cau hinh o gpio_dir_pins_init)
}

void motor_set_FL(float speed_rad_s)
{
    if (speed_rad_s >= 0) { GPIOB->BSRR = (1u<<0);      GPIOA->BSRR = (1u<<(4+16)); }
    else                  { GPIOB->BSRR = (1u<<16);     GPIOA->BSRR = (1u<<4);      }
    TIM1->CCR1 = speed_to_duty(MOTOR_FL, speed_rad_s);
}

void motor_set_FR(float speed_rad_s)
{
    if (speed_rad_s >= 0) { GPIOC->BSRR = (1u<<0);      GPIOC->BSRR = (1u<<(1+16)); }
    else                  { GPIOC->BSRR = (1u<<16);     GPIOC->BSRR = (1u<<1);      }
    TIM1->CCR2 = speed_to_duty(MOTOR_FR, speed_rad_s);
}

void motor_set_RL(float speed_rad_s)
{
    if (speed_rad_s >= 0) { GPIOC->BSRR = (1u<<(4+16)); GPIOC->BSRR = (1u<<5);      }
    else                  { GPIOC->BSRR = (1u<<4);      GPIOC->BSRR = (1u<<(5+16)); }
    TIM1->CCR3 = speed_to_duty(MOTOR_RL, speed_rad_s);
}

void motor_set_RR(float speed_rad_s)
{
    if (speed_rad_s >= 0) { GPIOC->BSRR = (1u<<2);      GPIOC->BSRR = (1u<<(3+16)); }
    else                  { GPIOC->BSRR = (1u<<(2+16)); GPIOC->BSRR = (1u<<3);      }
    TIM1->CCR4 = speed_to_duty(MOTOR_RR, speed_rad_s);
}

void motor_set_all(float w_FL, float w_FR, float w_RL, float w_RR)
{
    motor_set_FL(w_FL);
    motor_set_FR(w_FR);
    motor_set_RL(w_RL);
    motor_set_RR(w_RR);
}

static uint32_t clamp_duty(int32_t d)
{
    if (d < 0) d = -d;
    if (d > (int32_t)(PWM_MAX - 1)) d = (int32_t)(PWM_MAX - 1);
    return (uint32_t)d;
}

void motor_set_duty_raw(int32_t d_FL, int32_t d_FR, int32_t d_RL, int32_t d_RR)
{
    if (d_FL >= 0) { GPIOB->BSRR = (1u<<0);      GPIOA->BSRR = (1u<<(4+16)); }
    else           { GPIOB->BSRR = (1u<<16);     GPIOA->BSRR = (1u<<4);      }
    TIM1->CCR1 = clamp_duty(d_FL);

    if (d_FR >= 0) { GPIOC->BSRR = (1u<<0);      GPIOC->BSRR = (1u<<(1+16)); }
    else           { GPIOC->BSRR = (1u<<16);     GPIOC->BSRR = (1u<<1);      }
    TIM1->CCR2 = clamp_duty(d_FR);

    if (d_RL >= 0) { GPIOC->BSRR = (1u<<(4+16)); GPIOC->BSRR = (1u<<5);      }
    else           { GPIOC->BSRR = (1u<<4);      GPIOC->BSRR = (1u<<(5+16)); }
    TIM1->CCR3 = clamp_duty(d_RL);

    if (d_RR >= 0) { GPIOC->BSRR = (1u<<2);      GPIOC->BSRR = (1u<<(3+16)); }
    else           { GPIOC->BSRR = (1u<<(2+16)); GPIOC->BSRR = (1u<<3);      }
    TIM1->CCR4 = clamp_duty(d_RR);
}
