snepytago/Four-Wheel-Mecanum-Robot/Core/Src/usart6.c

#include "usart6.h"
#include "stm32f4xx.h"
#include <string.h>

void usart6_init(void)
{
    RCC->AHB1ENR |= RCC_AHB1ENR_GPIOCEN;
    RCC->APB2ENR |= RCC_APB2ENR_USART6EN;

    GPIOC->MODER &= ~(3u<<12);
    GPIOC->MODER |=  (2u<<12);

    GPIOC->PUPDR &= ~(3u<<12);
    GPIOC->PUPDR |=  (1u<<12);   // pull-up PC6 chong ky tu rac luc boot

    GPIOC->AFR[0] = (GPIOC->AFR[0] & ~(0xFu << 24)) | (0x8u << 24);   // AF8 = USART6_TX

    USART6->BRR = (8u << 4) | 11u;   // 115200 baud @ PCLK2=16MHz (thay cho 9600)
    USART6->CR1 |= USART_CR1_TE;
    USART6->CR1 |= USART_CR1_UE;
}

void usart6_send_char(char c)
{
    while (!(USART6->SR & (1u << 7)));
    USART6->DR = c;
}

void usart6_send_string(const char *str)
{
    while (*str) usart6_send_char(*str++);
}

void usart6_send_int(int32_t val)
{
    char buf[12]; int i = 0; uint8_t neg = 0;
    if (val < 0) { neg = 1; val = -val; }
    if (val == 0) buf[i++] = '0';
    while (val > 0) { buf[i++] = '0' + (val % 10); val /= 10; }
    if (neg) buf[i++] = '-';
    while (i > 0) usart6_send_char(buf[--i]);
}

void usart6_send_float(float val, uint8_t decimals)
{
    if (val < 0) { usart6_send_char('-'); val = -val; }
    int32_t int_part = (int32_t)val;
    usart6_send_int(int_part);
    usart6_send_char('.');
    float frac = val - (float)int_part;
    for (uint8_t i = 0; i < decimals; i++) {
        frac *= 10.0f;
        int digit = (int)frac;
        usart6_send_char('0' + digit);
        frac -= (float)digit;
    }
}

// ============================================================================
// RX - nhan lenh tu gateway (qua esp32R) tren chan PC7 (AF8), dung chung
// baudrate/BRR da cau hinh trong usart6_init() (PHAI goi usart6_init() truoc).
//
// Co che: ngat RXNE nhan tung byte -> gom vao rx_building -> gap ky tu ket
// thuc ('\n', '\r' hoac '#') thi day ca dong vao HANG DOI vong (ring buffer)
// de main loop doc dan. Hang doi nhieu dong la bat buoc vi gateway ban cac
// dong theo cum trong vai ms, con main loop chi doc 50 lan/giay.
//
// Con tro: rx_head do IRQ tang (ghi vao), rx_tail do main loop tang (doc ra).
// Hang doi coi la DAY khi con 1 o trong - de phan biet ro "day" voi "rong"
// ma khong can bien dem rieng (tranh phai khoa giua IRQ va main loop).
// ============================================================================

static volatile char     rx_q[USART6_RX_QUEUE_LEN][USART6_RX_LINE_MAXLEN];
static volatile uint16_t rx_q_len[USART6_RX_QUEUE_LEN];
static volatile uint16_t rx_head = 0;
static volatile uint16_t rx_tail = 0;
static volatile uint32_t rx_dropped = 0;

static volatile char     rx_building[USART6_RX_LINE_MAXLEN];
static volatile uint16_t rx_building_len = 0;

void usart6_rx_init(void)
{
    // Clock GPIOC + USART6 da bat trong usart6_init() (TX).

    // PC7 = Alternate Function AF8 (USART6_RX)
    GPIOC->MODER &= ~(3u << 14);
    GPIOC->MODER |=  (2u << 14);        // 10: Alternate function mode

    GPIOC->PUPDR &= ~(3u << 14);
    GPIOC->PUPDR |=  (1u << 14);        // pull-up: tranh doc nhieu khi chua noi day

    GPIOC->AFR[0] = (GPIOC->AFR[0] & ~(0xFu << 28)) | (0x8u << 28);   // AF8 = USART6_RX tren PC7

    rx_head = rx_tail = 0;
    rx_building_len = 0;
    rx_dropped = 0;

    USART6->CR1 |= USART_CR1_RE | USART_CR1_RXNEIE;

    NVIC_SetPriority(USART6_IRQn, 5);
    NVIC_EnableIRQ(USART6_IRQn);
}

uint8_t usart6_rx_line_ready(void)
{
    return (rx_head != rx_tail) ? 1 : 0;
}

void usart6_rx_get_line(char *out_buf, uint16_t max_len)
{
    if (rx_head == rx_tail) {       // khong co dong nao -> tra chuoi rong
        if (max_len > 0) out_buf[0] = '\0';
        return;
    }

    uint16_t n = rx_q_len[rx_tail];
    if (n > (uint16_t)(max_len - 1)) n = (uint16_t)(max_len - 1);

    memcpy(out_buf, (const void *)rx_q[rx_tail], n);
    out_buf[n] = '\0';

    // Chi tang tail SAU khi da copy xong: IRQ nhin vao tail de biet o nao
    // con ban, nen o dang doc phai duoc giu den giay cuoi cung.
    rx_tail = (uint16_t)((rx_tail + 1) % USART6_RX_QUEUE_LEN);
}

uint32_t usart6_rx_get_dropped(void)
{
    return rx_dropped;
}

void USART6_IRQHandler(void)
{
    if (USART6->SR & USART_SR_RXNE) {
        char c = (char)(USART6->DR & 0xFF);   // doc DR cung tu xoa co RXNE

        if (c == '\n' || c == '\r' || c == '#') {
            if (rx_building_len > 0) {
                uint16_t next = (uint16_t)((rx_head + 1) % USART6_RX_QUEUE_LEN);

                if (next == rx_tail) {
                    rx_dropped++;          // hang doi day -> bo dong nay
                } else {
                    memcpy((void *)rx_q[rx_head], (const void *)rx_building, rx_building_len);
                    rx_q_len[rx_head] = rx_building_len;
                    rx_head = next;
                }
            }
            rx_building_len = 0;
        } else if (rx_building_len < (USART6_RX_LINE_MAXLEN - 1)) {
            rx_building[rx_building_len++] = c;
        } else {
            rx_building_len = 0;   // dong qua dai/mat dong bo -> huy, doi dong tiep
        }
    }

    // Overrun error (ORE): PHAI doc SR roi doc DR de xoa co, neu khong ngat
    // se bi "ket" va khong nhan them byte nao nua.
    if (USART6->SR & USART_SR_ORE) {
        (void)USART6->DR;
    }
}
