snepytago/Four-Wheel-Mecanum-Robot/(commit log)

2026-08-21 Initial commit: FWMR mecanum robot firmware (STM32F401RE)
2026-08-25 Add real-time keyboard teleop via UART6 RX (ESP32 relay)
    - usart6: add interrupt-driven RX line reader (PC7, USART6_RX)
    - config: TELEOP_MODE_ENABLE + safety clamps + watchdog timeout
    - main: teleop control loop (V,<vx_mm>,<vy_mm>,<wz_mrad> over UART6),
    bypasses auto test scenarios when enabled
    - README: document teleop mode and protocol
2026-08-25 Add ESP32 + Python keyboard teleop
2026-09-21 Simplify main loop: drop auto test scenarios and inline teleop parsing
    - main.c: remove TEST_SQUARE/TEST_ARC scenarios and keyboard-teleop
    command parsing; loop now just holds heading via gyro P-controller
    with target_vx_world/target_vy_world fixed at 0
    - config.h: drop test-scenario and teleop-specific constants
    - usart6: keep interrupt-driven UART6 RX line reader as unintegrated
    infrastructure for a future external command source (ESP32 + ArUco
    camera positioning, see planning notes)
    - README: reflect simplified control loop and current roadmap
    [config.h, main.c, usart6.c, usart6.h]
2026-09-23 Add camera+ArUco absolute positioning and PWM threshold test
    - pose_link: parse gateway pose lines (esp32C -> esp32R -> UART6 RX),
    watchdog + per-line-type counters, reject out-of-range values
    (no checksum on the wire)
    - odometry/mpu6050: odometry_set_pose()/mpu6050_set_yaw_deg() to
    snap (x,y,theta) to the camera's absolute frame on each new frame,
    dead-reckoning via encoder+gyro fills the gaps between frames
    - usart6: RX upgraded from single-line to an 8-line ring queue,
    '#' added as a line terminator (matches gateway protocol), track
    dropped-line count
    - pwm_test: 2-phase startup-PWM-threshold test per wheel (no-load via
    encoder, on-floor via camera as referee) to size a futu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
    [config.h, esp32_robot.ino, main.c, mpu6050.c, mpu6050.h, odometry.c, odometry.h, pose_link.c]
2026-09-24 Calibrate per-wheel PWM offsets, add theta-sign and straight-line tests
    - motor: speed_to_duty() now duty = OFFSET[wheel] + K_FF*|w|, per-wheel
    offset instead of pure linear feed-forward (static friction varies
    up to 39% between the 4 motors)
    - config: K_FF 29.3 -> 23.3, add MOTOR_DUTY_OFFSET_FL/FR/RL/RR,
    PWM_TH_* (phase-1 thresholds), ROBOT_V_MIN/MOTOR_OMEGA_MIN,
    POSE_CHECK_ENABLE, STRAIGHT_TEST_ENABLE
    - pwm_test: add pose_theta_check_run() (confirms camera/gyro theta
    sign convention match - verified 24/09) and straight_test_run()
    (validates K_FF/heading loop/camera latency on the real control
    path, currently the active boot mode)
    - pwm_test2: support PWM_TEST2_USE_OFFSET to s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
2026-09-28 Them bai go-to-point dau tien (goto_test.c), bat GOTO_TEST_ENABLE
    - Them goto_test.h/c: chay thang toi 1 diem dich tren dung duong van
    hanh that (odometry + vong giu huong), snap pose xuat phat tu trung
    binh camera, san toc do toi thieu tinh rieng theo huong di cheo
    (v_floor_for) thay vi dung chung ROBOT_V_MIN.
    - main.c: goi goto_test_run() khi GOTO_TEST_ENABLE=1.
    - config.h: them cac hang so GTP_*, bat GOTO_TEST_ENABLE=1, tat lai
    STRAIGHT_TEST_ENABLE ve 0 (bai chay thang da xong).
    - Cap nhat README: module goto_test, muc 5 trong bai do/kiem tra,
    canh bao co dang bat.
    [config.h, goto_test.h, main.c, odometry.c]
2026-10-15 Them EKF + viet lai go-to-point, bai chay thuan encoder, bo pwm_test
    - Them ekf.h/c: EKF 4 trang thai (X,Y,theta,bias gyro) tron camera (bu tre
    200ms qua lich su 1.28s, cong Mahalanobis, tu nap lai khi lac huong) voi
    encoder+gyro.
    - Viet lai goto_test.h/c: may trang thai SETTLE/ROTATE/DRIVE/WAIT_CAM/DONE
    dung pose EKF, xuat phat vi tri bat ky, tu xoay huong ve dich (GOTO_FACE_GOAL),
    thu lai toi da 10 lan, resnap theo camera luc dung yen, xu ly STOP qua gateway.
    - Them enc_run_test.h/c: bai chay thang thuan encoder (khong camera) de do
    lech tu nhien 4 banh - phat hien banh RR yeu hon cau truc (cham hon RL 7-10%).
    - pose_link.c: xu ly lenh STOP (pose_link_take_stop).
    - esp32_robot.in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
2026-10-20 Them strafe_cal_test, rot_cal_test, zigzag_test; EKF them ekf_reset_jump
    - zigzag_test.c/h: bai 19 buoc (di + quay dau 180 + ve), 3 mode encoder/encoder+IMU/EKF. Dang bat ZZ_MODE=1.
    - rot_cal_test.c/h, strafe_cal_test.c/h: hieu chuan quay tai cho / chay ngang (buoc 0-1 cua zigzag).
    - config.h, main.c: them co + loi goi cho 3 bai tren, giu #error chi bat 1 bai.
    - ekf.h/c: them ekf_reset_jump() de do do nhay vi tri khi nap lai.
    - README: ghi nhan bai dang bat + ket qua zigzag 20/10.
